Beehive-Engineering/Minibadge-Displays/4x7 Display/Combined PCBs bottom side.png

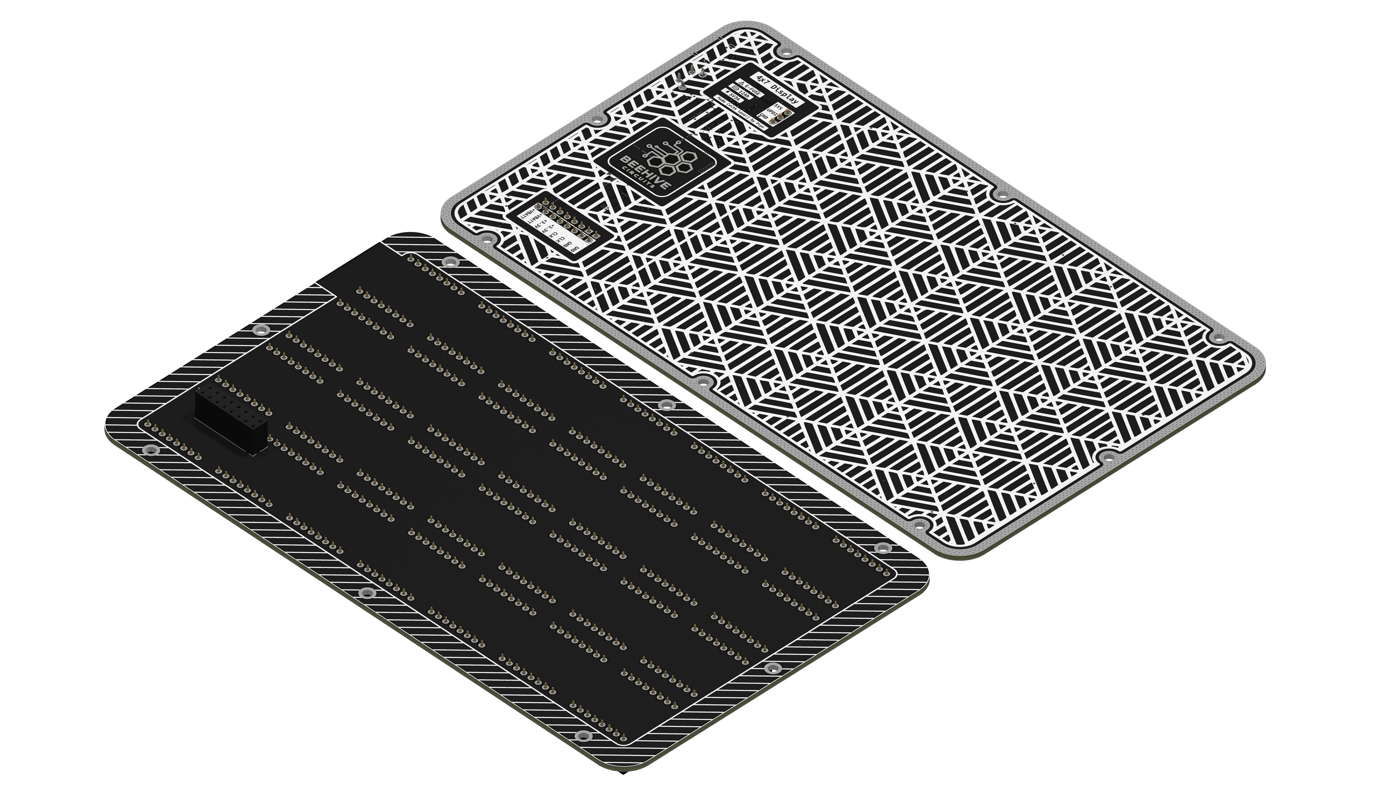
4x7 Display/Combined PCBs bottom side.png
