Beehive-Engineering/Minibadge-Displays/4x7 Display/Combined PCBs top side.png

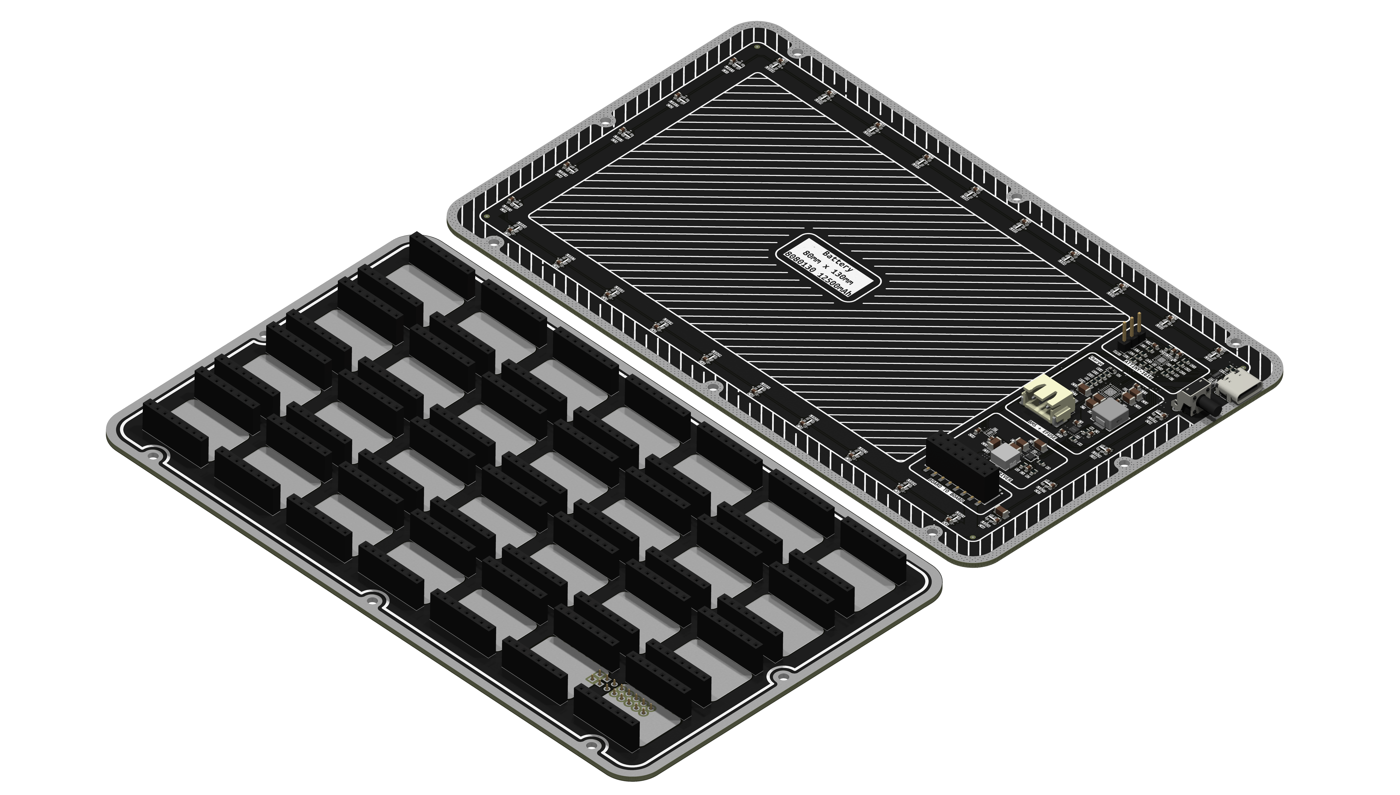
4x7 Display/Combined PCBs top side.png
