Beehive-Engineering/Minibadge-Displays/4x7 Display/Front PCB bottom.png

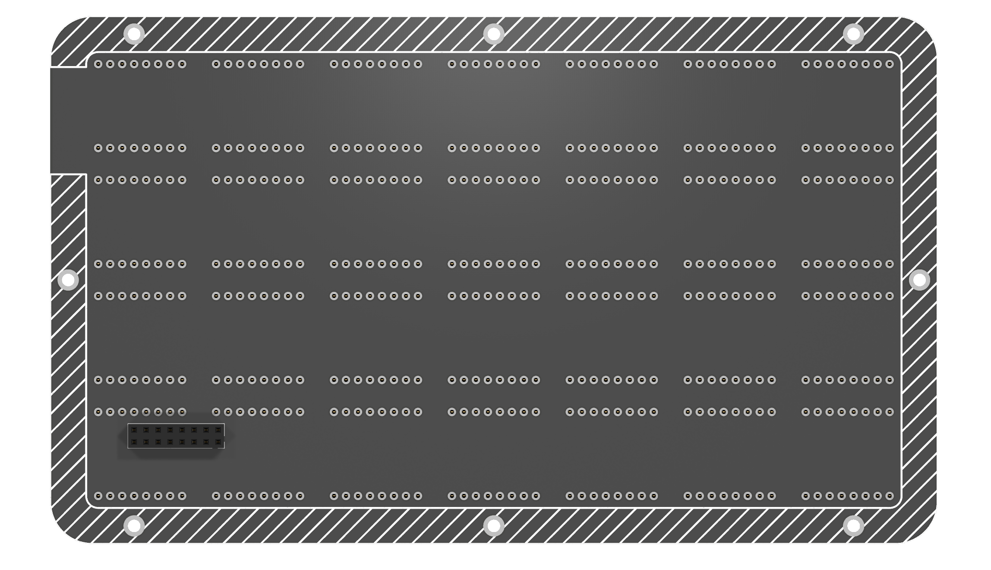
4x7 Display/Front PCB bottom.png
