Beehive-Engineering/Minibadge-Displays/4x7 Display/Front PCB top.png

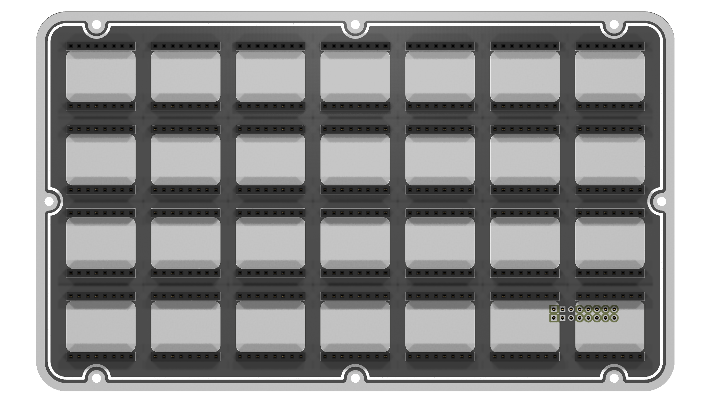
4x7 Display/Front PCB top.png
