Beehive-Engineering/Minibadge-Displays/4x7 Display/Main PCB bottom.png

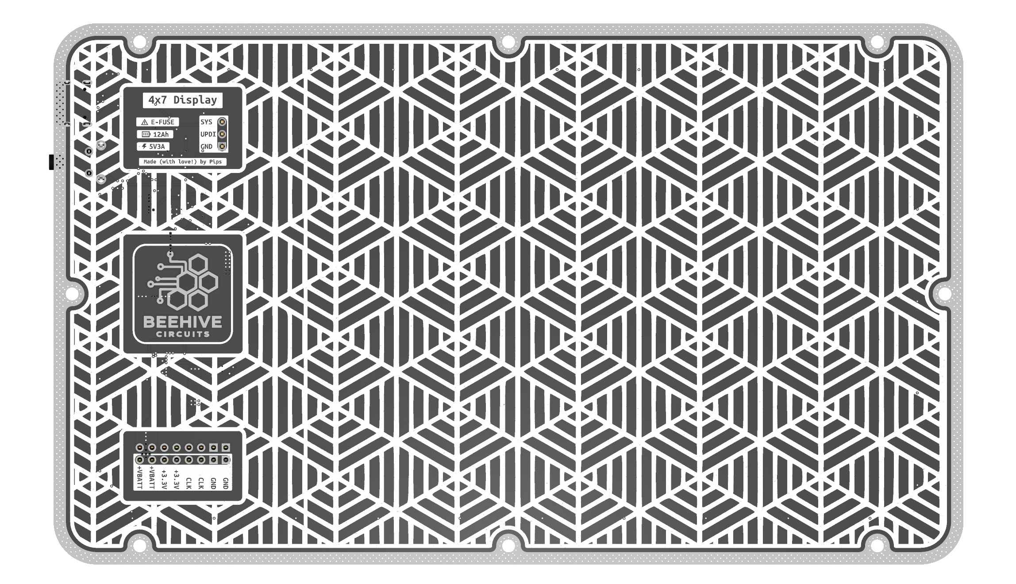
4x7 Display/Main PCB bottom.png
