Beehive-Engineering/Minibadge-Displays/4x7 Display/Main PCB top.png

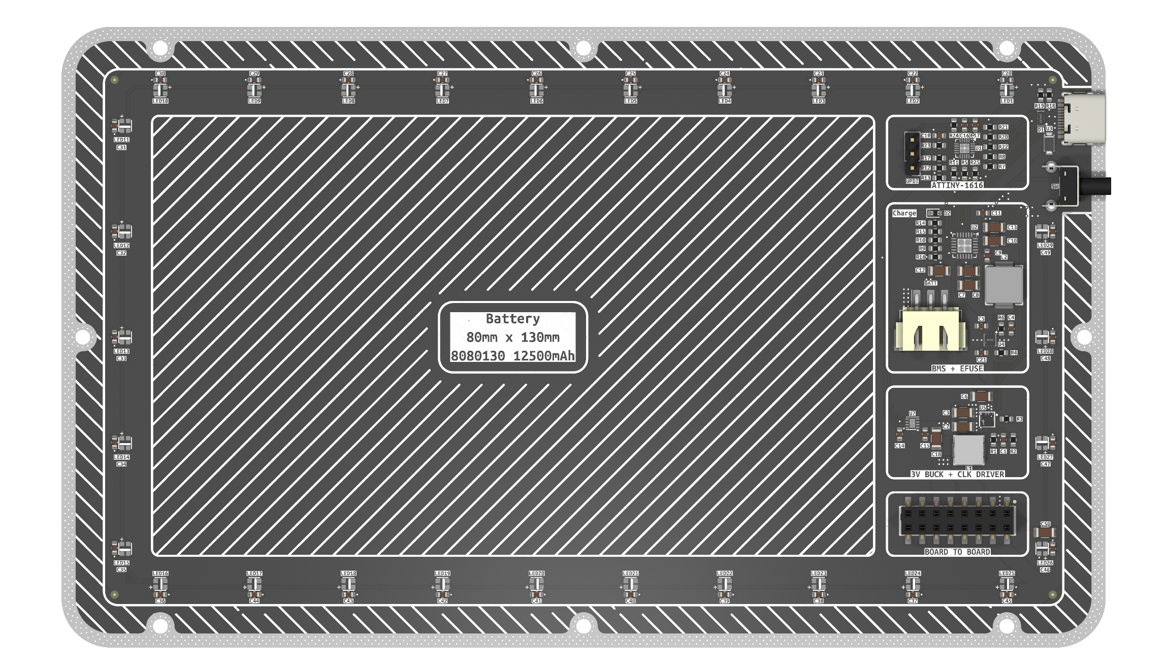
4x7 Display/Main PCB top.png
