Beehive-Engineering/Minibadge-Displays/4x7 Display/seamless-geometric-pattern-black-white-silhouette-abstract-repeating-thick-lines-115651497.webp

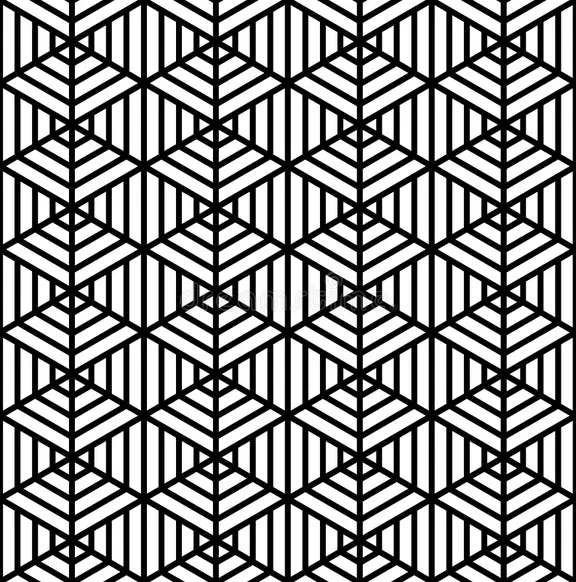
4x7 Display/seamless-geometric-pattern-black-white-silhouette-abstract-repeating-thick-lines-115651497.webp
