Beehive-Engineering/Minibadge-Displays/4x7 Display/4x7 Display-User_Comments.dxf

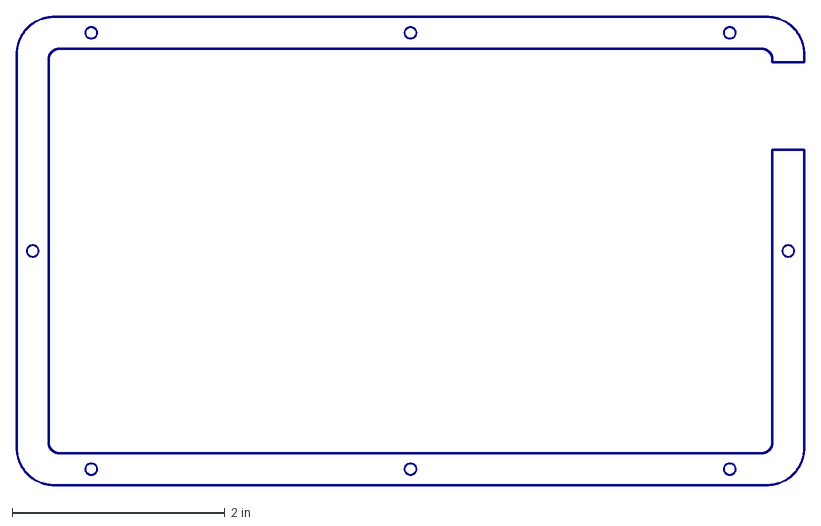
[picture p9: CAD file, 2026-11-13]
4x7 Display/4x7 Display-User_Comments.dxf
7.41 x 4.41 in
