Beehive-Engineering/Minibadge-Displays/4x7 Display/4x7 Display Schematic.pdf

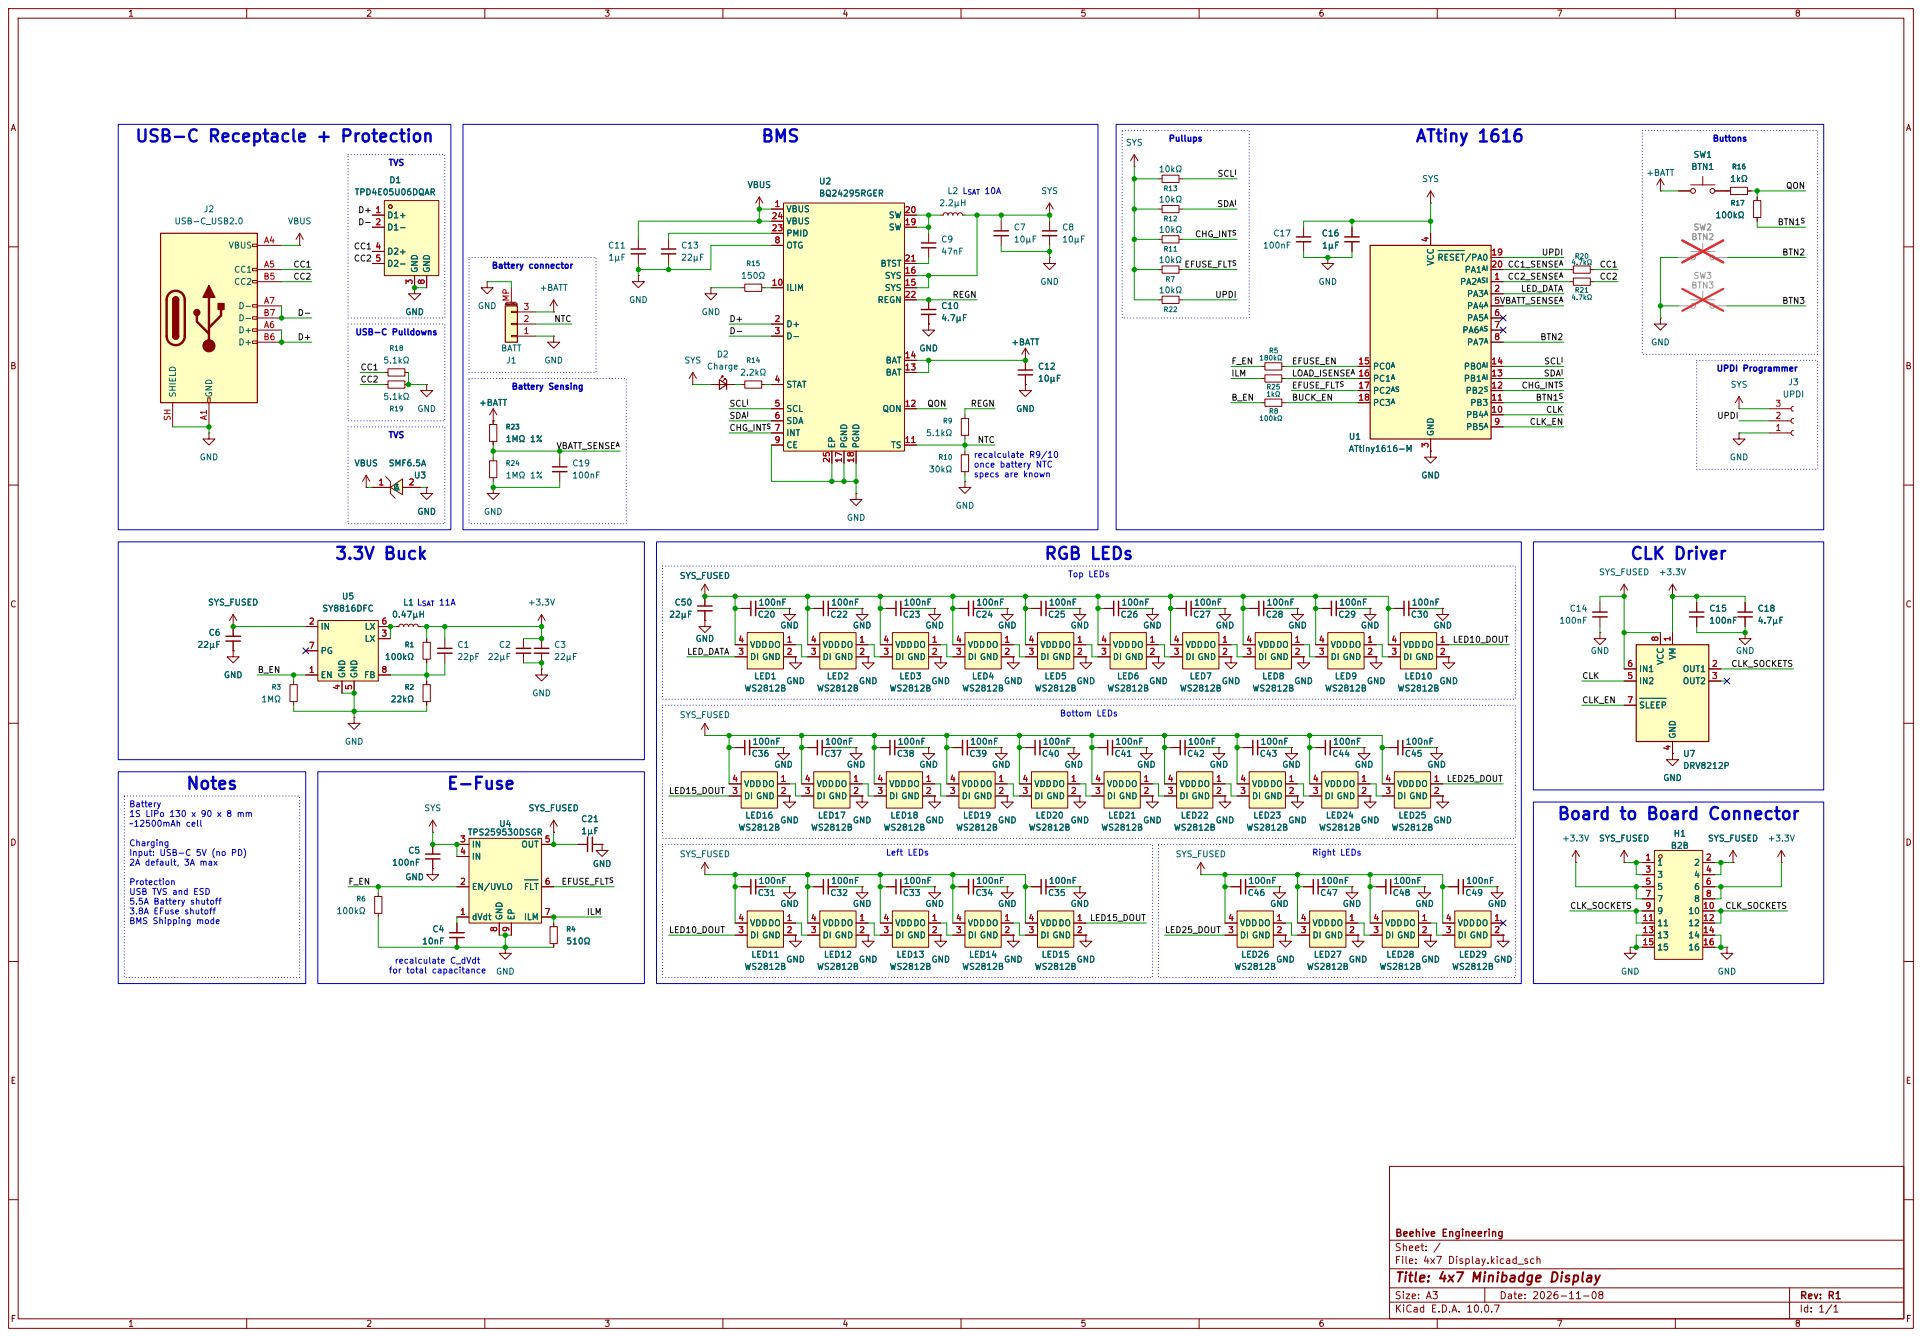
[picture p10: page 1]

VBUS C11
SYS 15 SYS 16 PGND 17 PGND 18

REGN
TS 11 QON 12 BAT 13 BAT 14
UPDI Programmer Left LEDs

Input: USB-C 5V (no PD) 2A default, 3A max Protection USB TVS and ESD

5.5A Battery shutoff 3.8A EFuse shutoff BMS Shipping mode

Size: A3 | Rev: R1 | F Date: 2026-11-08
KiCad E.D.A. 10.0.7 | Id: 1/1
