Beehive-Engineering/Minibadge-Displays/4x7 Display/4x7 Display Drawing.pdf

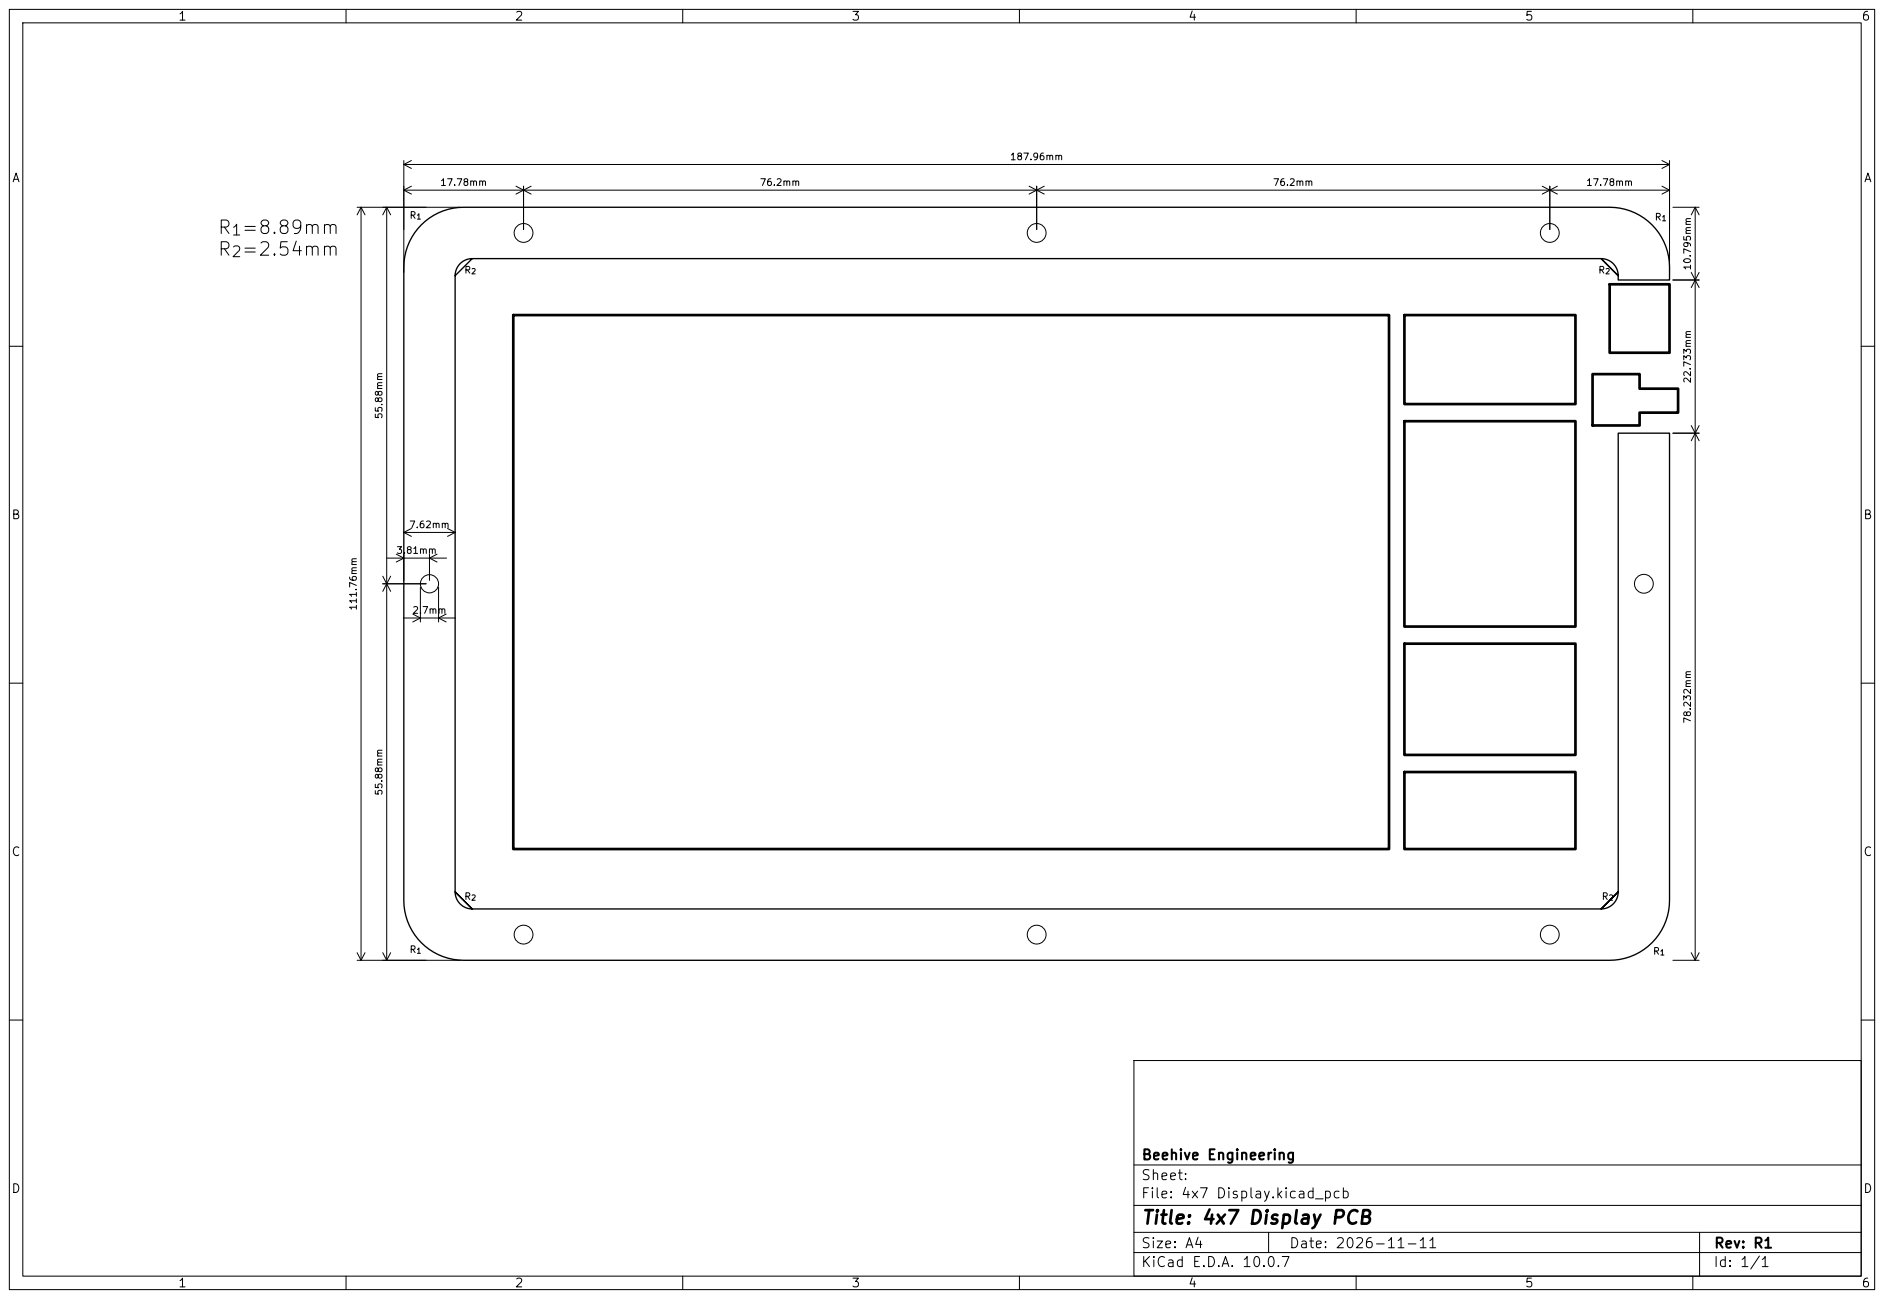
[picture p11: page 1]

Size: A4 | Rev: R1
KiCad E.D.A. 10.0.7 | Id: 1/1
