Beehive-Engineering/Minibadge-Displays/4x7 Display/4x7 Display PCB.pdf

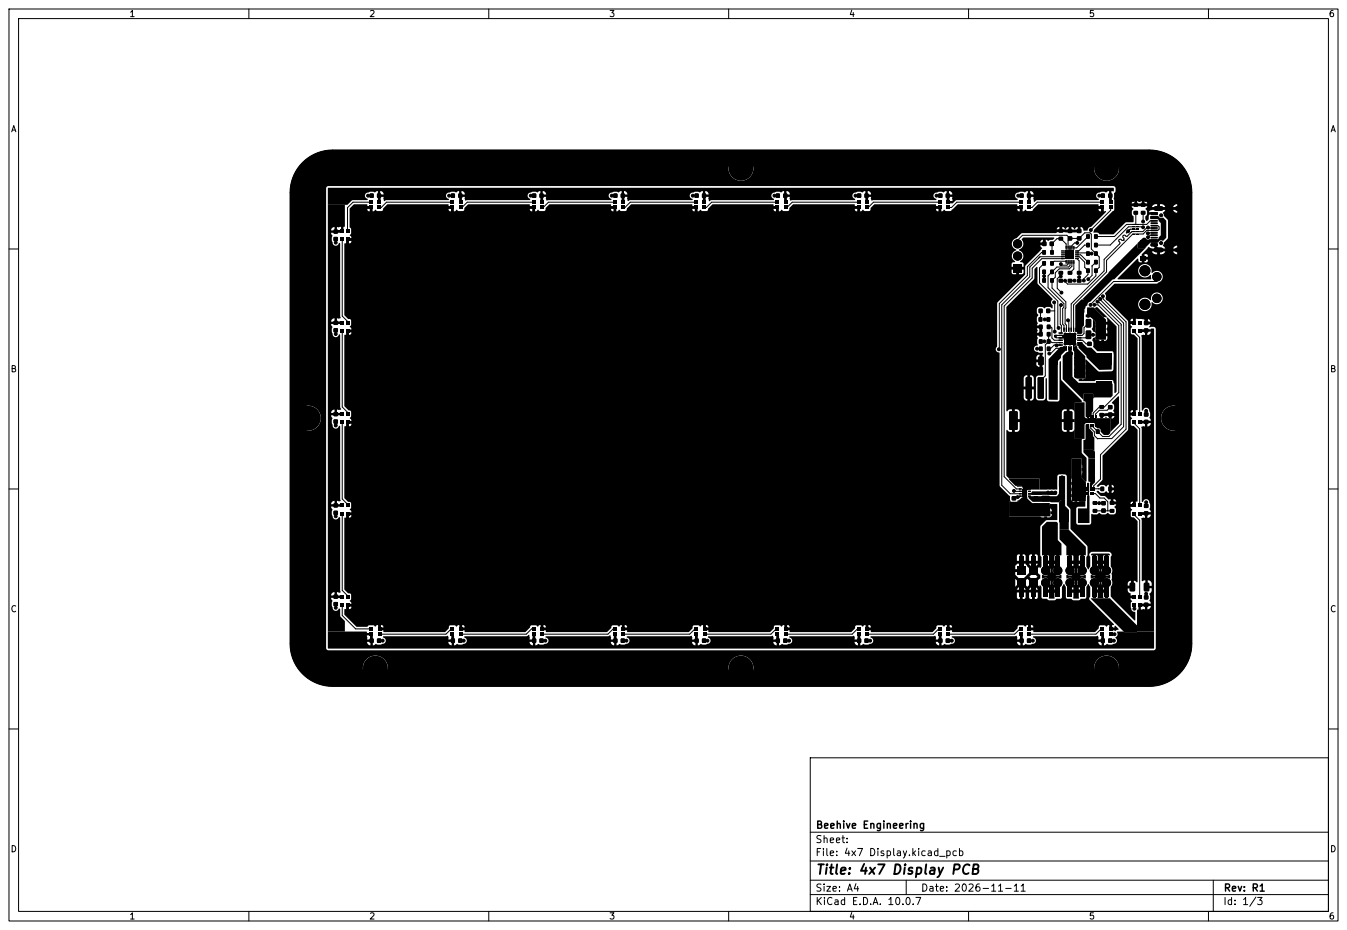
[picture p12: page 1]

Size: A4 | Rev: R1
KiCad E.D.A. 10.0.7 | Id: 1/3

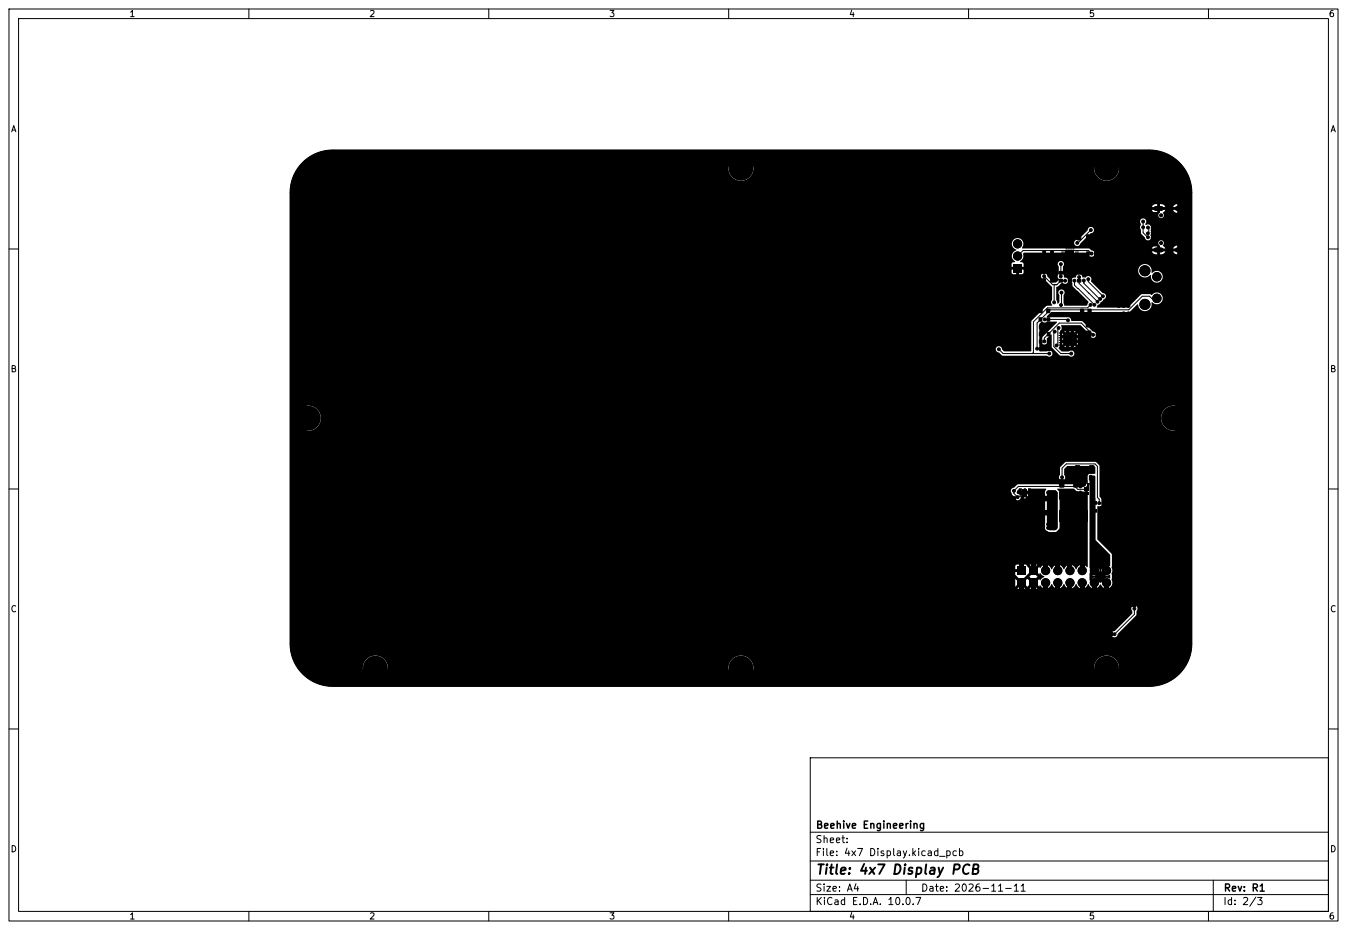
[picture p13: page 2]

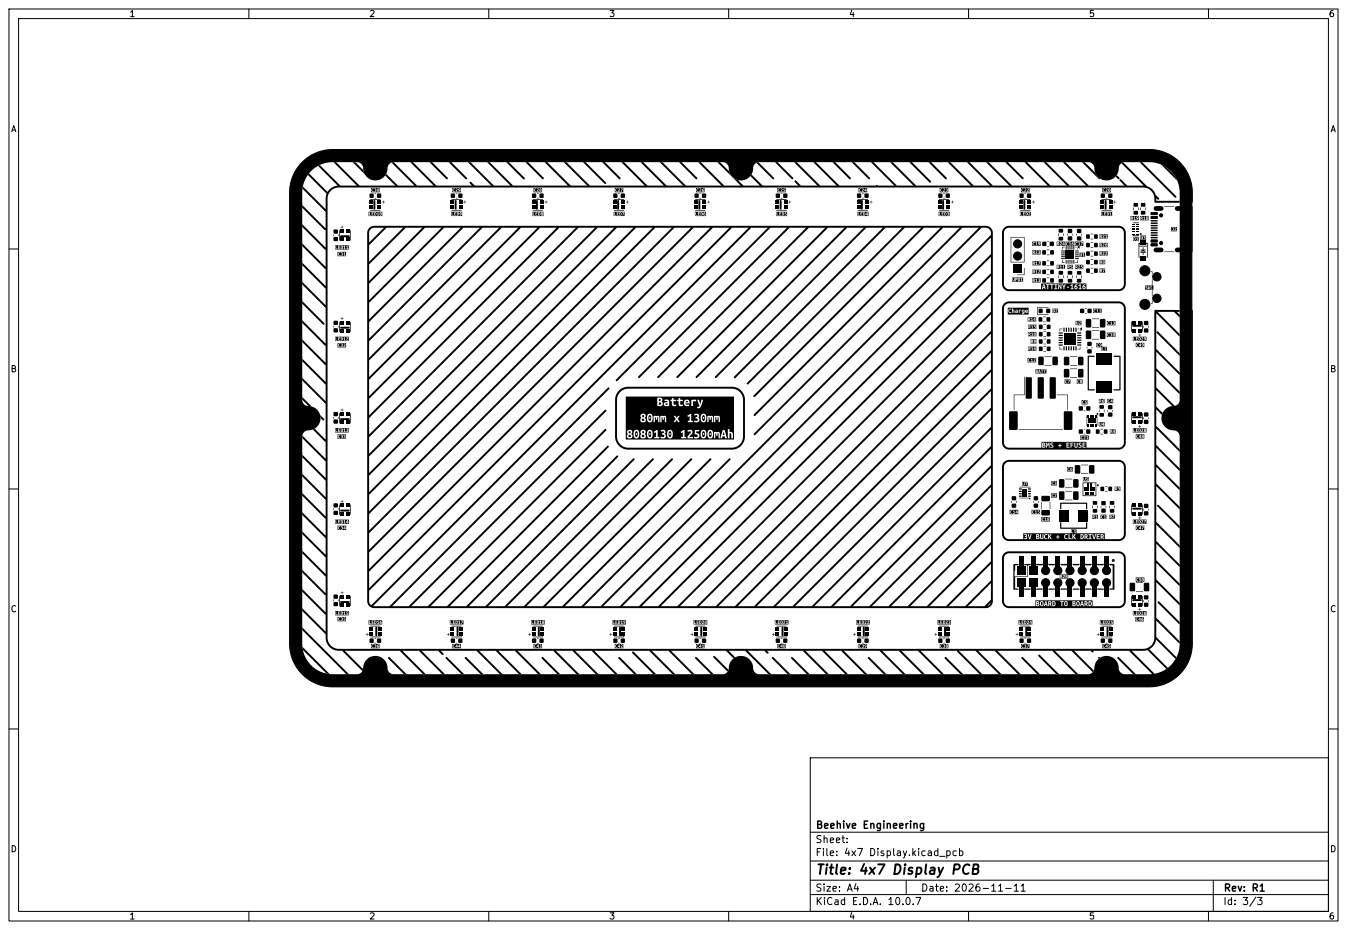
[picture p14: page 3]
