Beehive-Engineering/Minibadge-Displays/4x7 Display/4x7 Display Spacer.pdf

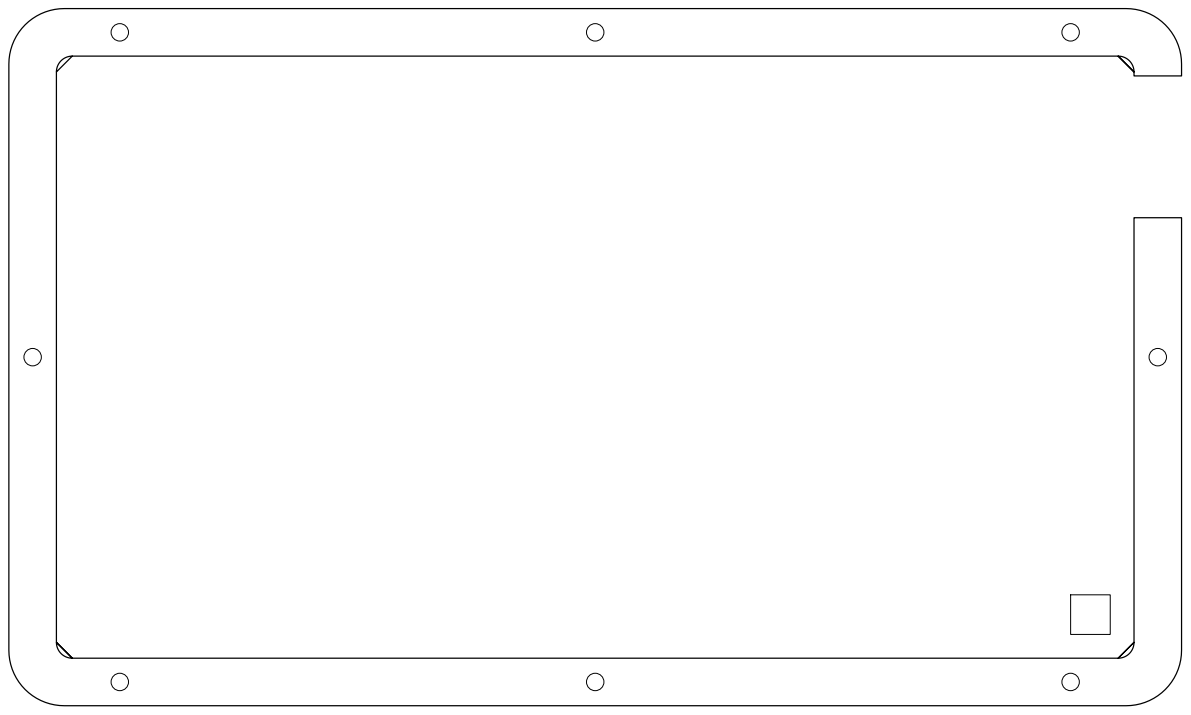
[picture p15: page 1]
