Beehive-Engineering/Minibadge-Displays/4x7 Display/4x7 Display-B_Silkscreen.pdf

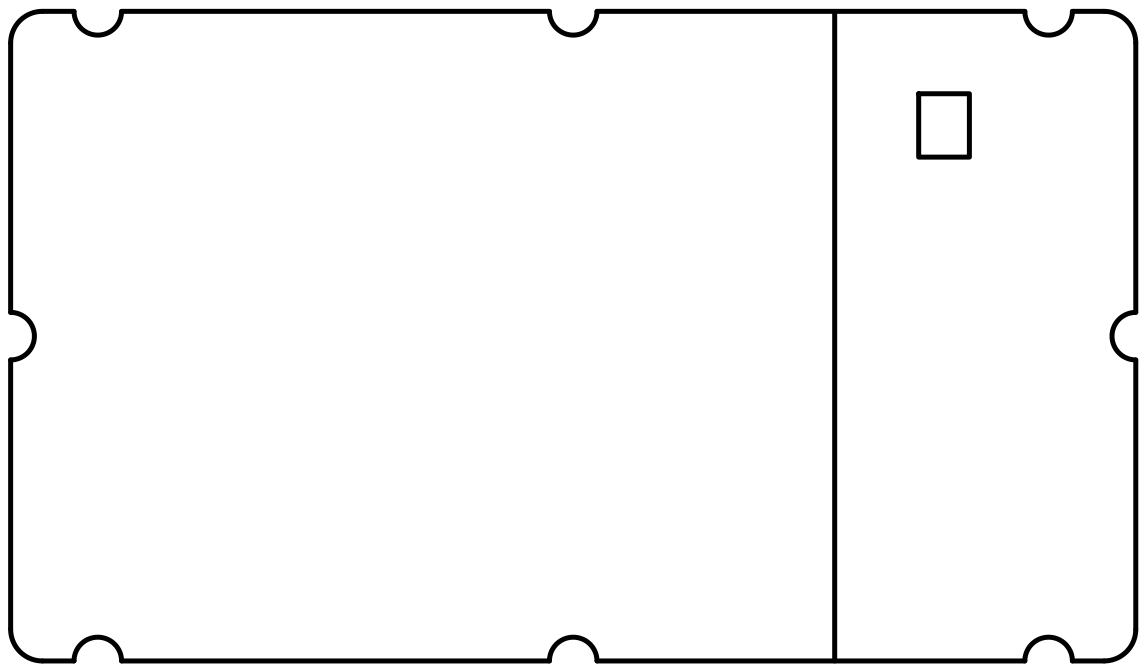
[picture p16: page 1]
