Beehive-Engineering/Minibadge-Displays/4x7 Display/4x7 Display.kicad_pcb

## KiCad design 4x7 Display/4x7 Display.kicad_pcb (2026-11-13)

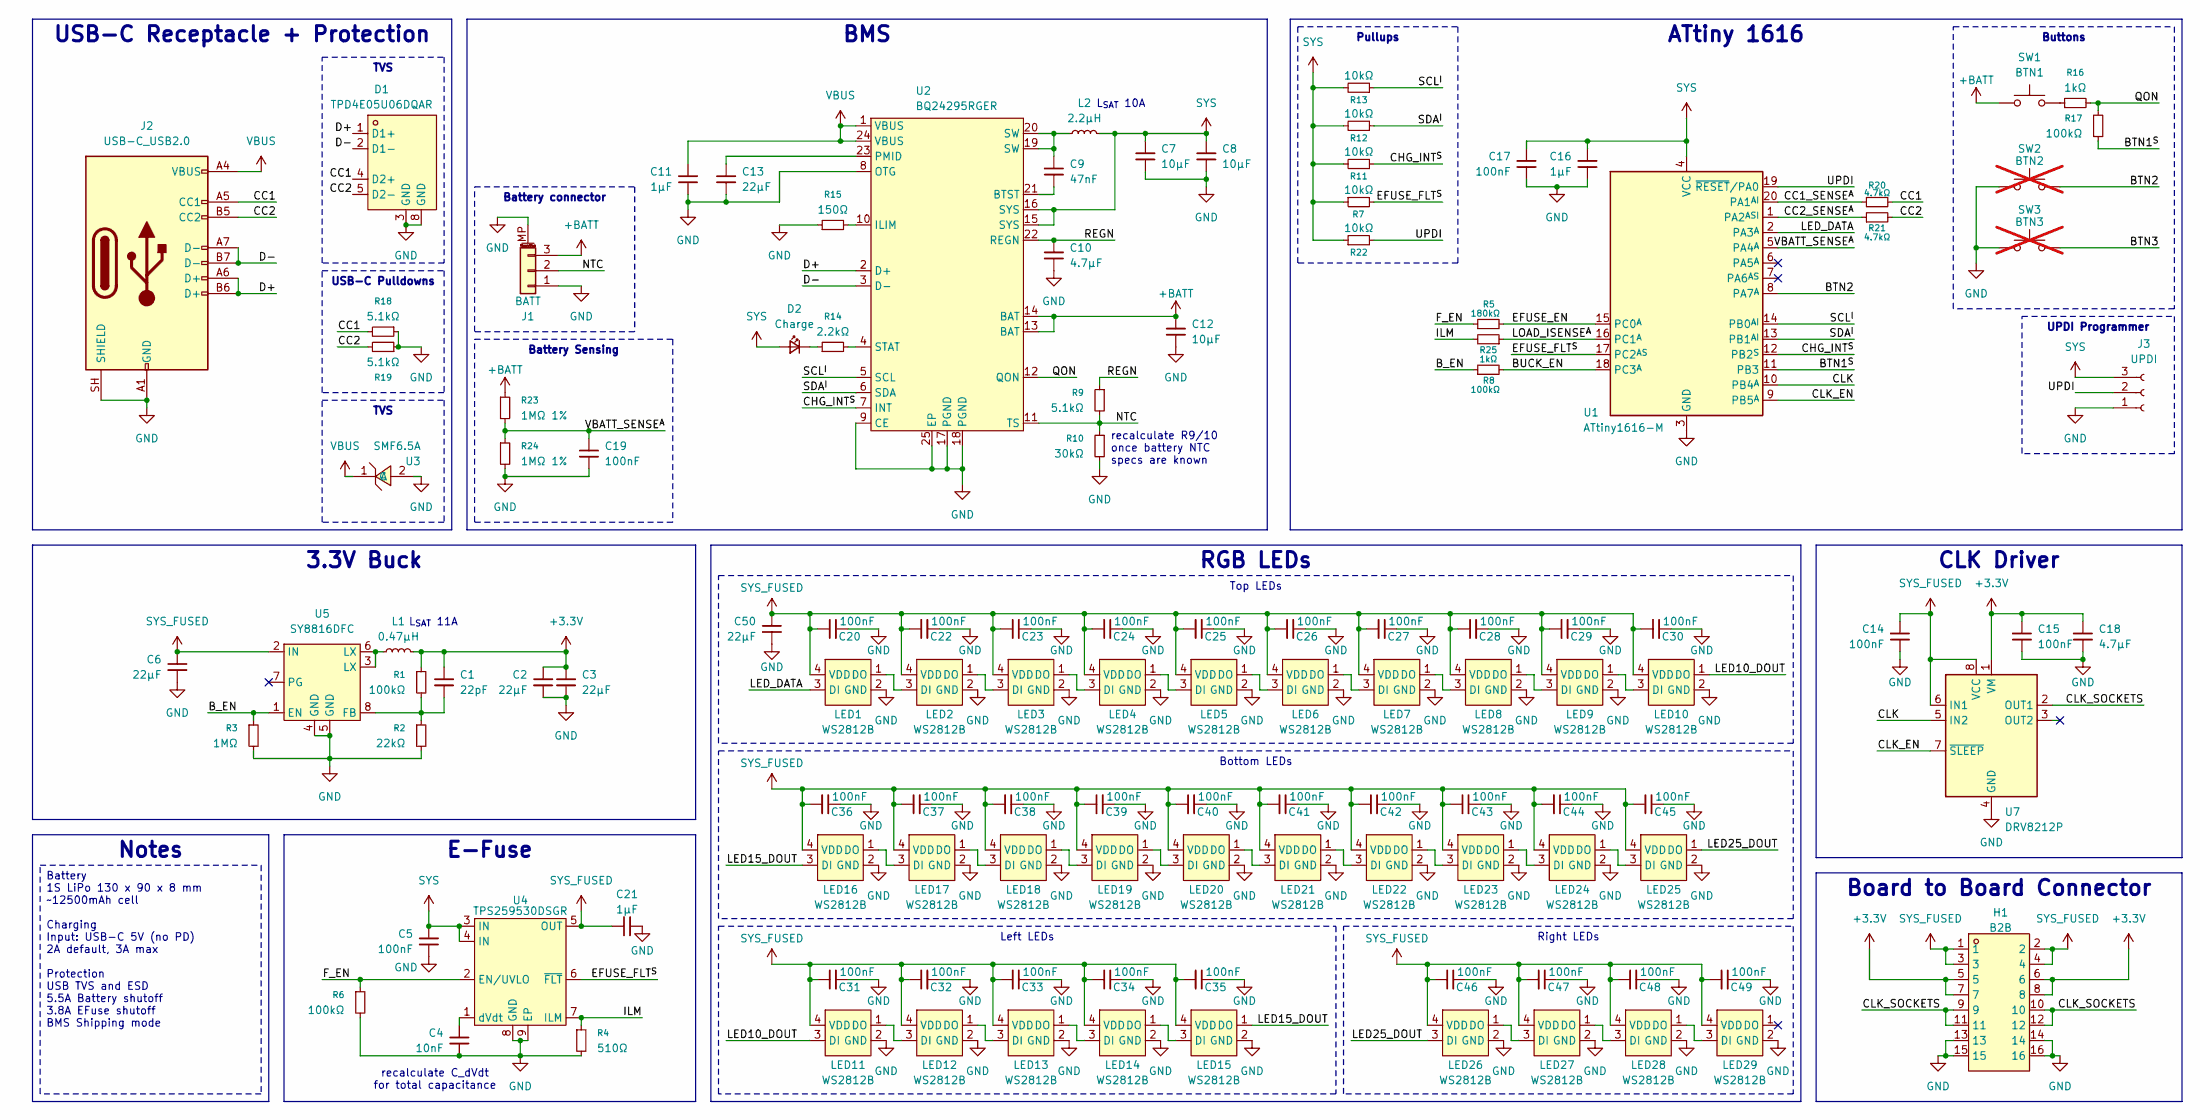
[picture p17: schematic 4x7 Display.kicad_sch, 4x7 Minibadge Display]

Parts:
C1: 22pF; C_0603_1608Metric; LCSC Part # C1653
C2, C3, C6, C13, C50: 22μF; C_1206_3216Metric; LCSC Part # C12891
C4: 10nF; C_0603_1608Metric; LCSC Part # C57112
C5, C14, C15, C17, C19, C20, C22, C23, C24, C25, C26, C27, C28, C29, C30, C31, C32, C33, C34, C35, C36, C37, C38, C39, C40, C41, C42, C43, C44, C45, C46, C47, C48, C49: 100nF; C_0603_1608Metric; LCSC Part # C14663
C7, C8, C12: 10μF; C_1206_3216Metric; LCSC Part # C13585
C9: 47nF; C_0603_1608Metric; LCSC Part # C1622
C10, C18: 4.7μF; C_1206_3216Metric; LCSC Part # C29823
C11, C16, C21: 1μF; C_0603_1608Metric; LCSC Part # C15849
D1: TPD4E05U06DQAR; USON-10_L2.5-W1.0-P0.50-BL; MPN TPD4E05U06DQAR; LCSC Part C138714
D2: Charge; D_0603_1608Metric; LCSC Part # C2286
H1: B2B; HDR-SMD_16P-P2.54-V-F-R2-C8-LS7.1; MPN PM254-2-08-S-8.5; LCSC Part C3975153
J1: BATT; JST_XH_S3B-XH-SM4-TB_1x03-1MP_P2.50mm_Horizontal
J2: USB-C_USB2.0; USB_C_Receptacle_HRO_TYPE-C-31-M-12; LCSC Part # C165948
J3: UPDI; PinHeader_1x03_P2.54mm_Vertical
L1: 0.47μH; IND-SMD_L5.4-W5.2_FXL0530
L2: 2.2μH; IND-SMD_L7.0-W6.6; LCSC Part # C167218
LED1, LED2, LED3, LED4, LED5, LED6, LED7, LED8, LED9, LED10, LED11, LED12, LED13, LED14, LED15, LED16, LED17, LED18, LED19, LED20, LED21, LED22, LED23, LED24, LED25, LED26, LED27, LED28, LED29: WS2812B; LED-SMD_4P-L2.2-W2.0-P1.00_WS2815C-2020-4P; MPN WS2812B-2020-V6; LCSC Part C52917434
R1, R6, R8, R17: 100kΩ; R_0603_1608Metric; LCSC Part # C25803
R2: 22kΩ; R_0603_1608Metric; LCSC Part # C31850
R3: 1MΩ; R_0603_1608Metric; LCSC Part # C22935
R4: 510Ω; R_0603_1608Metric; LCSC Part # C23193
R5: 180kΩ; R_0603_1608Metric; LCSC Part # C22827
R7, R11, R12, R13, R22: 10kΩ; R_0603_1608Metric; LCSC Part # C25804
R9, R18, R19: 5.1kΩ; R_0603_1608Metric; LCSC Part # C23186
R10: 30kΩ; R_0603_1608Metric; LCSC Part # C22984
R14: 2.2kΩ; R_0603_1608Metric; LCSC Part # C4190
R15: 150Ω; R_0603_1608Metric; LCSC Part # C22808
R16, R25: 1kΩ; R_0603_1608Metric; LCSC Part # C21190
R20, R21: 4.7kΩ; R_0603_1608Metric; LCSC Part # C23162
R23, R24: 1MΩ 1%; R_0603_1608Metric; LCSC Part # C22935
SW1: BTN1; SW_Tactile_SPST_Angled_PTS645Vx83-2LFS; LCSC Part # C127486
SW2: BTN2; SW_Tactile_SPST_Angled_PTS645Vx83-2LFS; LCSC Part # C125034; not fitted
SW3: BTN3; SW_Tactile_SPST_Angled_PTS645Vx83-2LFS; LCSC Part # C125034; not fitted
U1: ATtiny1616-M; VQFN-20-1EP_3x3mm_P0.4mm_EP1.7x1.7mm; LCSC Part # C507118
U2: BQ24295RGER; VQFN-24-1EP_4x4mm_P0.5mm_EP2.5x2.5mm_ThermalVias; MPN BQ24295RGER; LCSC Part C165144
U3: SMF6.5A; SOD-123FL_L2.8-W1.8-LS3.8-RD; MPN SMF6.5A; LCSC Part C5370410
U4: TPS259530DSGR; WSON-8_L2.0-W2.0-P0.50-TL-EP; MPN TPS259530DSGR; LCSC Part C2155775
U5: SY8816DFC; DFN-8_L2.0-W2.0_SY8816DFC; MPN SY8816DFC; LCSC Part C5440878
U7: DRV8212P; Texas_DSG0008A_WSON-8-1EP_2x2mm_P0.5mm_EP0.9x1.6mm_ThermalV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; LCSC Part # C5208051

Connections:
+3.3V: C1.1, C2.1, C3.1, C15.1, C18.1, H1.5, H1.6, H1.7, H1.8, L1.2, R1.1, U7.1 (VM)
+BATT: C12.1, J1.3, R23.1, SW1.1, U2.13 (BAT), U2.14 (BAT)
/BTN1^{S}: R17.1, U1.11 (PB3)
/BTN2: SW2.1, U1.8 (PA7^{A})
/BUCK_EN: R8.2, U1.18 (PC3^{A})
/B_EN: R3.1, R8.1, U5.1 (EN)
/CC1: D1.4 (D2+), J2.A5 (CC1), R18.2, R20.2
/CC1_SENSE^{A}: R20.1, U1.20 (PA1^{AI})
/CC2: D1.5 (D2-), J2.B5 (CC2), R19.2, R21.2
/CC2_SENSE^{A}: R21.1, U1.1 (PA2^{ASI})
/CHG_INT^{S}: R11.1, U1.12 (PB2^{S}), U2.7 (INT)
/CLK: U1.10 (PB4^{A}), U7.5 (IN2)
/CLK_EN: U1.9 (PB5^{A}), U7.7 (~SLEEP)
/CLK_SOCKETS: H1.9, H1.10, H1.11, H1.12, U7.2 (OUT1)
/D+: D1.1 (D1+), J2.A6 (D+), J2.B6 (D+), U2.2 (D+)
/D-: D1.2 (D1-), J2.A7 (D-), J2.B7 (D-), U2.3 (D-)
/EFUSE_EN: R5.2, U1.15 (PC0^{A})
/EFUSE_FLT^{S}: R7.2, U1.17 (PC2^{AS}), U4.6 (~FLT)
/F_EN: R5.1, R6.1, U4.2 (EN/UVLO)
/ILM: R4.1, R25.2, U4.7 (ILM)
/LED10_DOUT: LED10.1 (DO), LED11.3 (DI)
/LED15_DOUT: LED15.1 (DO), LED16.3 (DI)
/LED25_DOUT: LED25.1 (DO), LED26.3 (DI)
/LED_DATA: LED1.3 (DI), U1.2 (PA3^{A})
/LOAD_ISENSE^{A}: R25.1, U1.16 (PC1^{A})
/NTC: J1.2, R9.2, R10.1, U2.11 (TS)
/QON: R16.2, R17.2, U2.12 (QON)
/REGN: C10.1, R9.1, U2.22 (REGN)
/SCL^{I}: R13.1, U1.14 (PB0^{AI}), U2.5 (SCL)
/SDA^{I}: R12.1, U1.13 (PB1^{AI}), U2.6 (SDA)
/UPDI: J3.2, R22.2, U1.19 (~RESET/PA0)
/VBATT_SENSE^{A}: C19.1, R23.2, R24.1, U1.5 (PA4^{A})
GND: C2.2, C3.2, C4.2, C5.2, C6.2, C7.2, C8.2, C10.2, C11.2, C12.2, C13.1, C14.2, C15.2, C16.2, C17.2, C18.2, C19.2, C20.2, C21.2, C22.2, C23.2, C24.2, C25.2, C26.2, C27.2, C28.2, C29.2, C30.2, C31.2, C32.2, C33.2, C34.2, C35.2, C36.2, C37.2, C38.2, C39.2, C40.2, C41.2, C42.2, C43.2, C44.2, C45.2, C46.2, C47.2, C48.2, C49.2, C50.2, D1.3 (GND), D1.8 (GND), H1.13, H1.14, H1.15, H1.16, J1.1, J1.MP (MountPin), J2.A1 (GND), J2.A12 (GND), J2.B1 (GND), J2.B12 (GND), J2.SH (SHIELD), J3.1, LED1.2 (GND), LED2.2 (GND), LED3.2 (GND), LED4.2 (GND), LED5.2 (GND), LED6.2 (GND), LED7.2 (GND), LED8.2 (GND), LED9.2 (GND), LED10.2 (GND), LED11.2 (GND), LED12.2 (GND), LED13.2 (GND), LED14.2 (GND), LED15.2 (GND), LED16.2 (GND), LED17.2 (GND), LED18.2 (GND), LED19.2 (GND), LED20.2 (GND), LED21.2 (GND), LED22.2 (GND), LED23.2 (GND), LED24.2 (GND), LED25.2 (GND), LED26.2 (GND), LED27.2 (GND), LED28.2 (GND), LED29.2 (GND), R2.2, R3.2, R4.2, R6.2, R10.2, R15.1, R18.1, R19.1, R24.2, SW2.2, SW3.2, U1.3 (GND), U1.21 (GND), U2.8 (OTG), U2.9 (CE), U2.17 (PGND), U2.18 (PGND), U2.25 (EP), U3.2 (A), U4.8 (GND), U4.9 (EP), U5.4 (GND), U5.5 (GND), U7.4 (GND), U7.9 (GND)
unnamed: C9.1, L2.1, U2.19 (SW), U2.20 (SW)
unnamed: D2.1 (K), R14.1
unnamed: L1.1, U5.3 (LX), U5.6 (LX)
unnamed: LED1.1 (DO), LED2.3 (DI)
unnamed: LED2.1 (DO), LED3.3 (DI)
unnamed: LED3.1 (DO), LED4.3 (DI)
unnamed: LED4.1 (DO), LED5.3 (DI)
unnamed: LED5.1 (DO), LED6.3 (DI)
unnamed: LED6.1 (DO), LED7.3 (DI)
unnamed: LED7.1 (DO), LED8.3 (DI)
unnamed: LED8.1 (DO), LED9.3 (DI)
unnamed: LED9.1 (DO), LED10.3 (DI)
unnamed: LED11.1 (DO), LED12.3 (DI)
unnamed: LED12.1 (DO), LED13.3 (DI)
unnamed: LED13.1 (DO), LED14.3 (DI)
unnamed: LED14.1 (DO), LED15.3 (DI)
unnamed: LED16.1 (DO), LED17.3 (DI)
unnamed: LED17.1 (DO), LED18.3 (DI)
unnamed: LED18.1 (DO), LED19.3 (DI)
unnamed: LED19.1 (DO), LED20.3 (DI)
unnamed: LED20.1 (DO), LED21.3 (DI)
unnamed: LED21.1 (DO), LED22.3 (DI)
unnamed: LED22.1 (DO), LED23.3 (DI)
unnamed: LED23.1 (DO), LED24.3 (DI)
unnamed: LED24.1 (DO), LED25.3 (DI)
unnamed: LED26.1 (DO), LED27.3 (DI)
unnamed: LED27.1 (DO), LED28.3 (DI)
unnamed: LED28.1 (DO), LED29.3 (DI)
unnamed: R16.1, SW1.2
unnamed: C9.2, U2.21 (BTST)
unnamed: R15.2, U2.10 (ILIM)
unnamed: C13.2, U2.23 (PMID)
unnamed: R14.2, U2.4 (STAT)
unnamed: C4.1, U4.1 (dVdt)
unnamed: C1.2, R1.2, R2.1, U5.8 (FB)
SYS: C5.1, C7.1, C8.1, C16.1, C17.1, D2.2 (A), J3.3, L2.2, R7.1, R11.2, R12.2, R13.2, R22.1, U1.4 (VCC), U2.15 (SYS), U2.16 (SYS), U4.3 (IN), U4.4 (IN)
SYS_FUSED: C6.1, C14.1, C20.1, C21.1, C22.1, C23.1, C24.1, C25.1, C26.1, C27.1, C28.1, C29.1, C30.1, C31.1, C32.1, C33.1, C34.1, C35.1, C36.1, C37.1, C38.1, C39.1, C40.1, C41.1, C42.1, C43.1, C44.1, C45.1, C46.1, C47.1, C48.1, C49.1, C50.1, H1.1, H1.2, H1.3, H1.4, LED1.4 (VDD), LED2.4 (VDD), LED3.4 (VDD), LED4.4 (VDD), LED5.4 (VDD), LED6.4 (VDD), LED7.4 (VDD), LED8.4 (VDD), LED9.4 (VDD), LED10.4 (VDD), LED11.4 (VDD), LED12.4 (VDD), LED13.4 (VDD), LED14.4 (VDD), LED15.4 (VDD), LED16.4 (VDD), LED17.4 (VDD), LED18.4 (VDD), LED19.4 (VDD), LED20.4 (VDD), LED21.4 (VDD), LED22.4 (VDD), LED23.4 (VDD), LED24.4 (VDD), LED25.4 (VDD), LED26.4 (VDD), LED27.4 (VDD), LED28.4 (VDD), LED29.4 (VDD), U4.5 (OUT), U5.2 (IN), U7.6 (IN1), U7.8 (VCC)
VBUS: C11.1, J2.A4 (VBUS), J2.A9 (VBUS), J2.B4 (VBUS), J2.B9 (VBUS), U2.1 (VBUS), U2.24 (VBUS), U3.1 (C)

Notes on the sheet:
L_{SAT} 10A
recalculate R9/10 once battery NTC specs are known
L_{SAT} 11A
recalculate C_dVdt for total capacitance
CLK Driver
Battery Sensing
USB-C Receptacle + Protection
TVS
Battery connector
Right LEDs
Battery 1S LiPo 130 x 90 x 8 mm ~12500mAh cell Charging Input: USB-C 5V (no PD) 2A default, 3A max Protection USB TVS and ESD 5.5A Battery shutoff 3.8A EFuse shutoff BMS Shipping mode
3.3V Buck
USB-C Pulldowns
Notes
Left LEDs
Pullups
ATtiny 1616
BMS
Buttons
E-Fuse
RGB LEDs
Board to Board Connector
Bottom LEDs
UPDI Programmer
Top LEDs

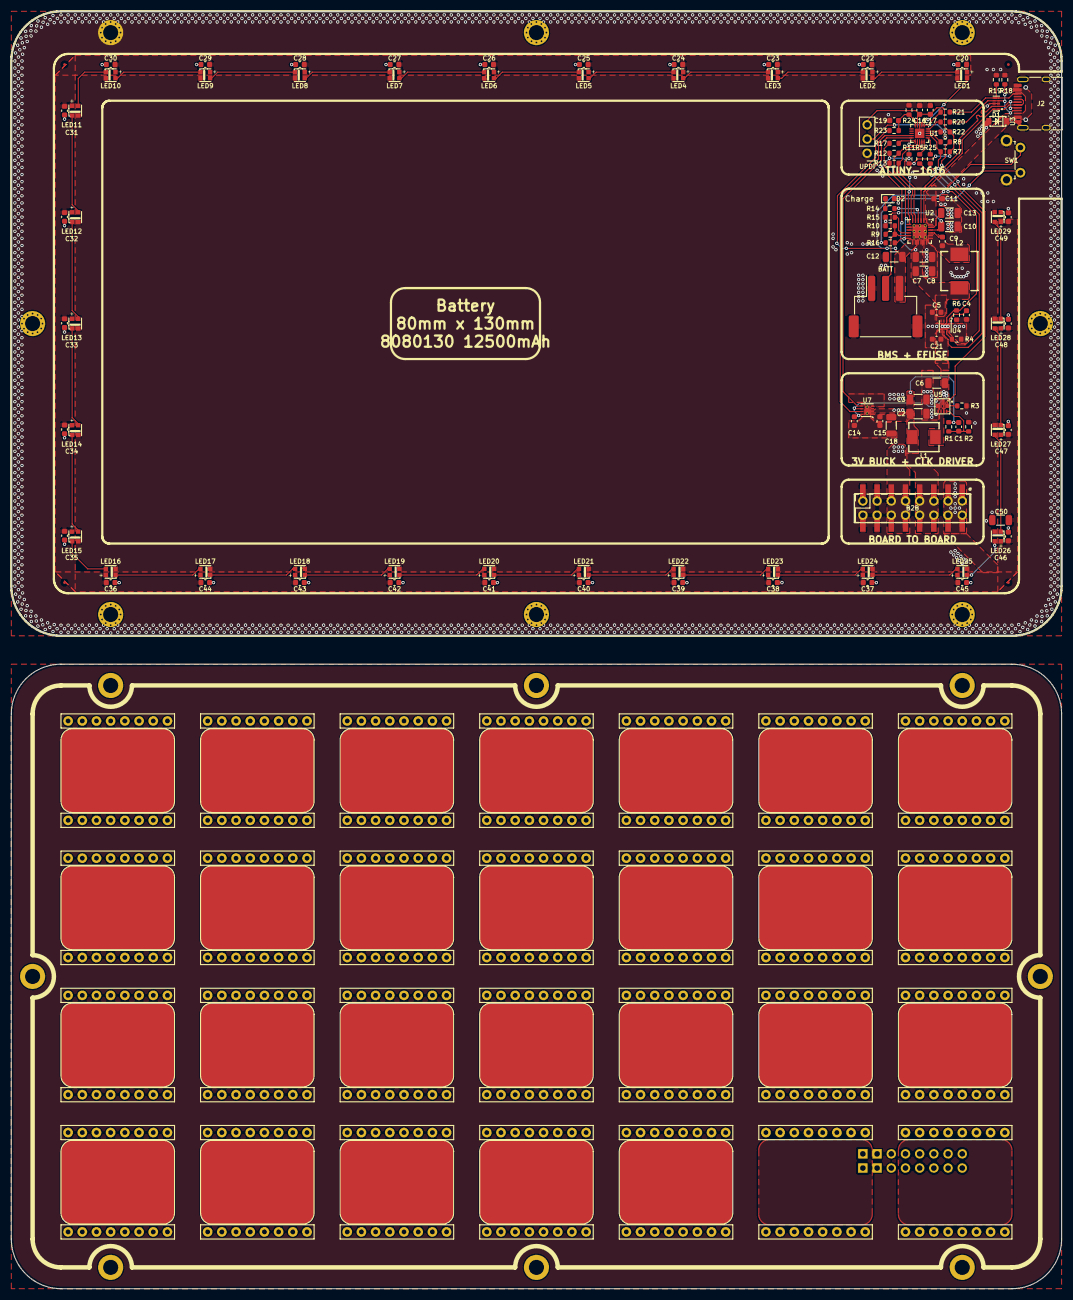
[picture p18: board 4x7 Display.kicad_pcb from above]

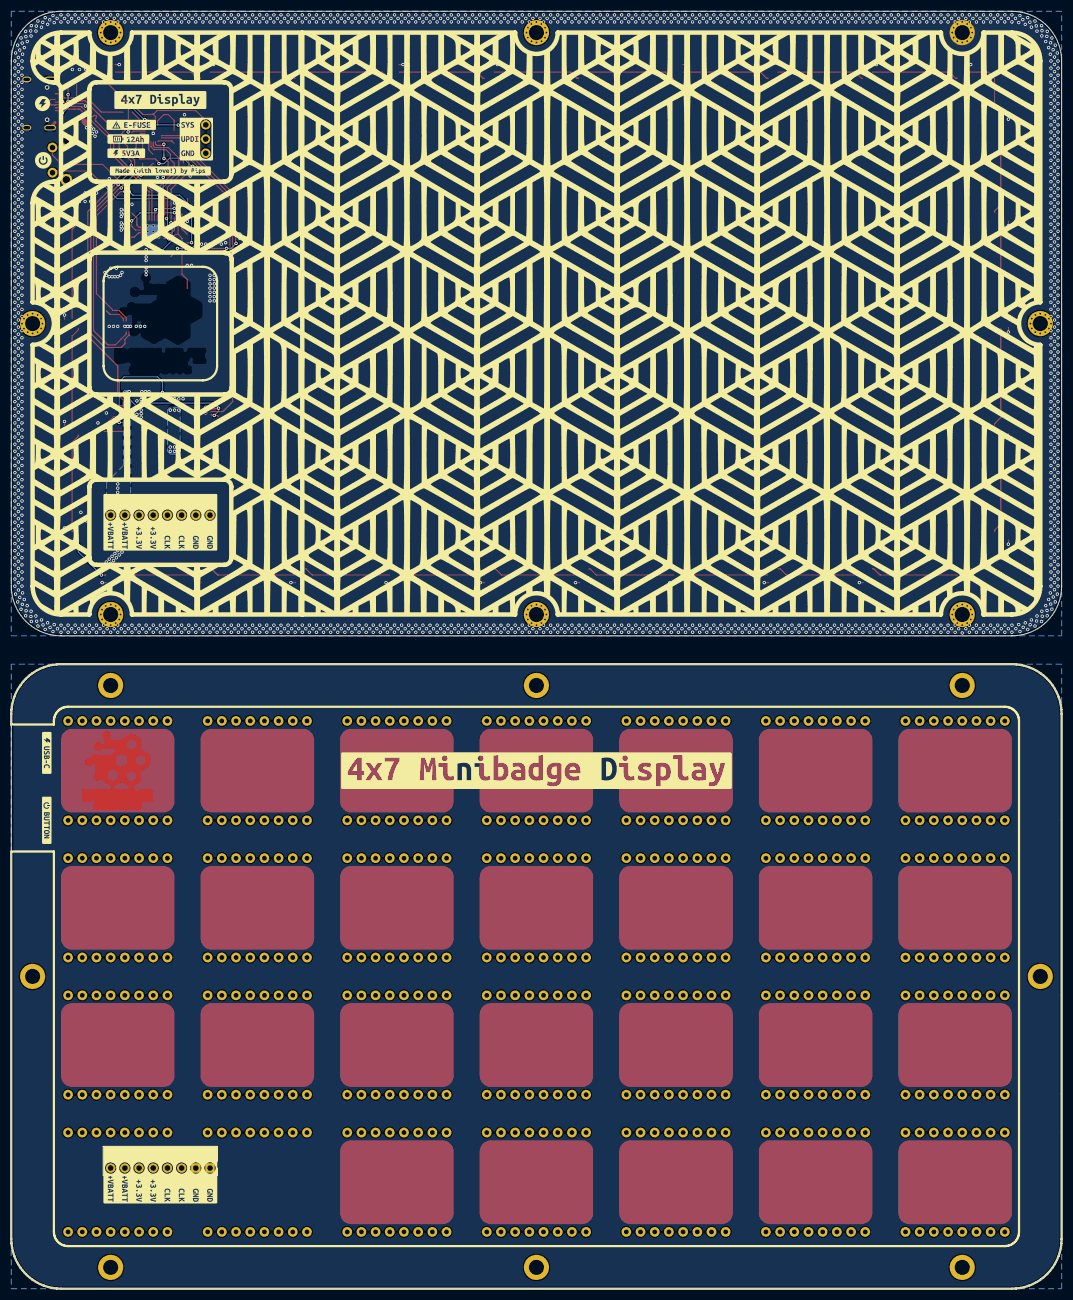
[picture p19: board 4x7 Display.kicad_pcb from below]

Board: 2 copper layers, 188.0 x 228.6 mm, 132 parts (13 on the bottom side), 70 nets.

Other parts of the board:
kobee-studio-6AF5A00E, kobee-studio-6AF59FA8, kobee-studio-6AF595D4, kobee-studio-6AF59616, kobee-studio-6AF59873: Kobee Studio; kobee-studio-6AF59280
kobee-studio-6AF6B32B, kobee-studio-6AF6B32B#2: Kobee Studio; kobee-studio-6AF51534
kobee-studio-6AF6C267: Kobee Studio; kobee-studio-6AF6C03E
kobee-studio-6AF59E14: Kobee Studio; kobee-studio-6AF517E5
kobee-studio-6AF62A46, kobee-studio-6AF62AB0: Kobee Studio; kobee-studio-6AF629F5
kobee-studio-6AF63128, kobee-studio-6AF63151: Kobee Studio; kobee-studio-6AF62E07
