Beehive-Engineering/Minibadge-Displays/Minibadge PD module/Minibadge PD module.kicad_pcb

## KiCad design Minibadge PD module/Minibadge PD module.kicad_pcb (2026-11-09)

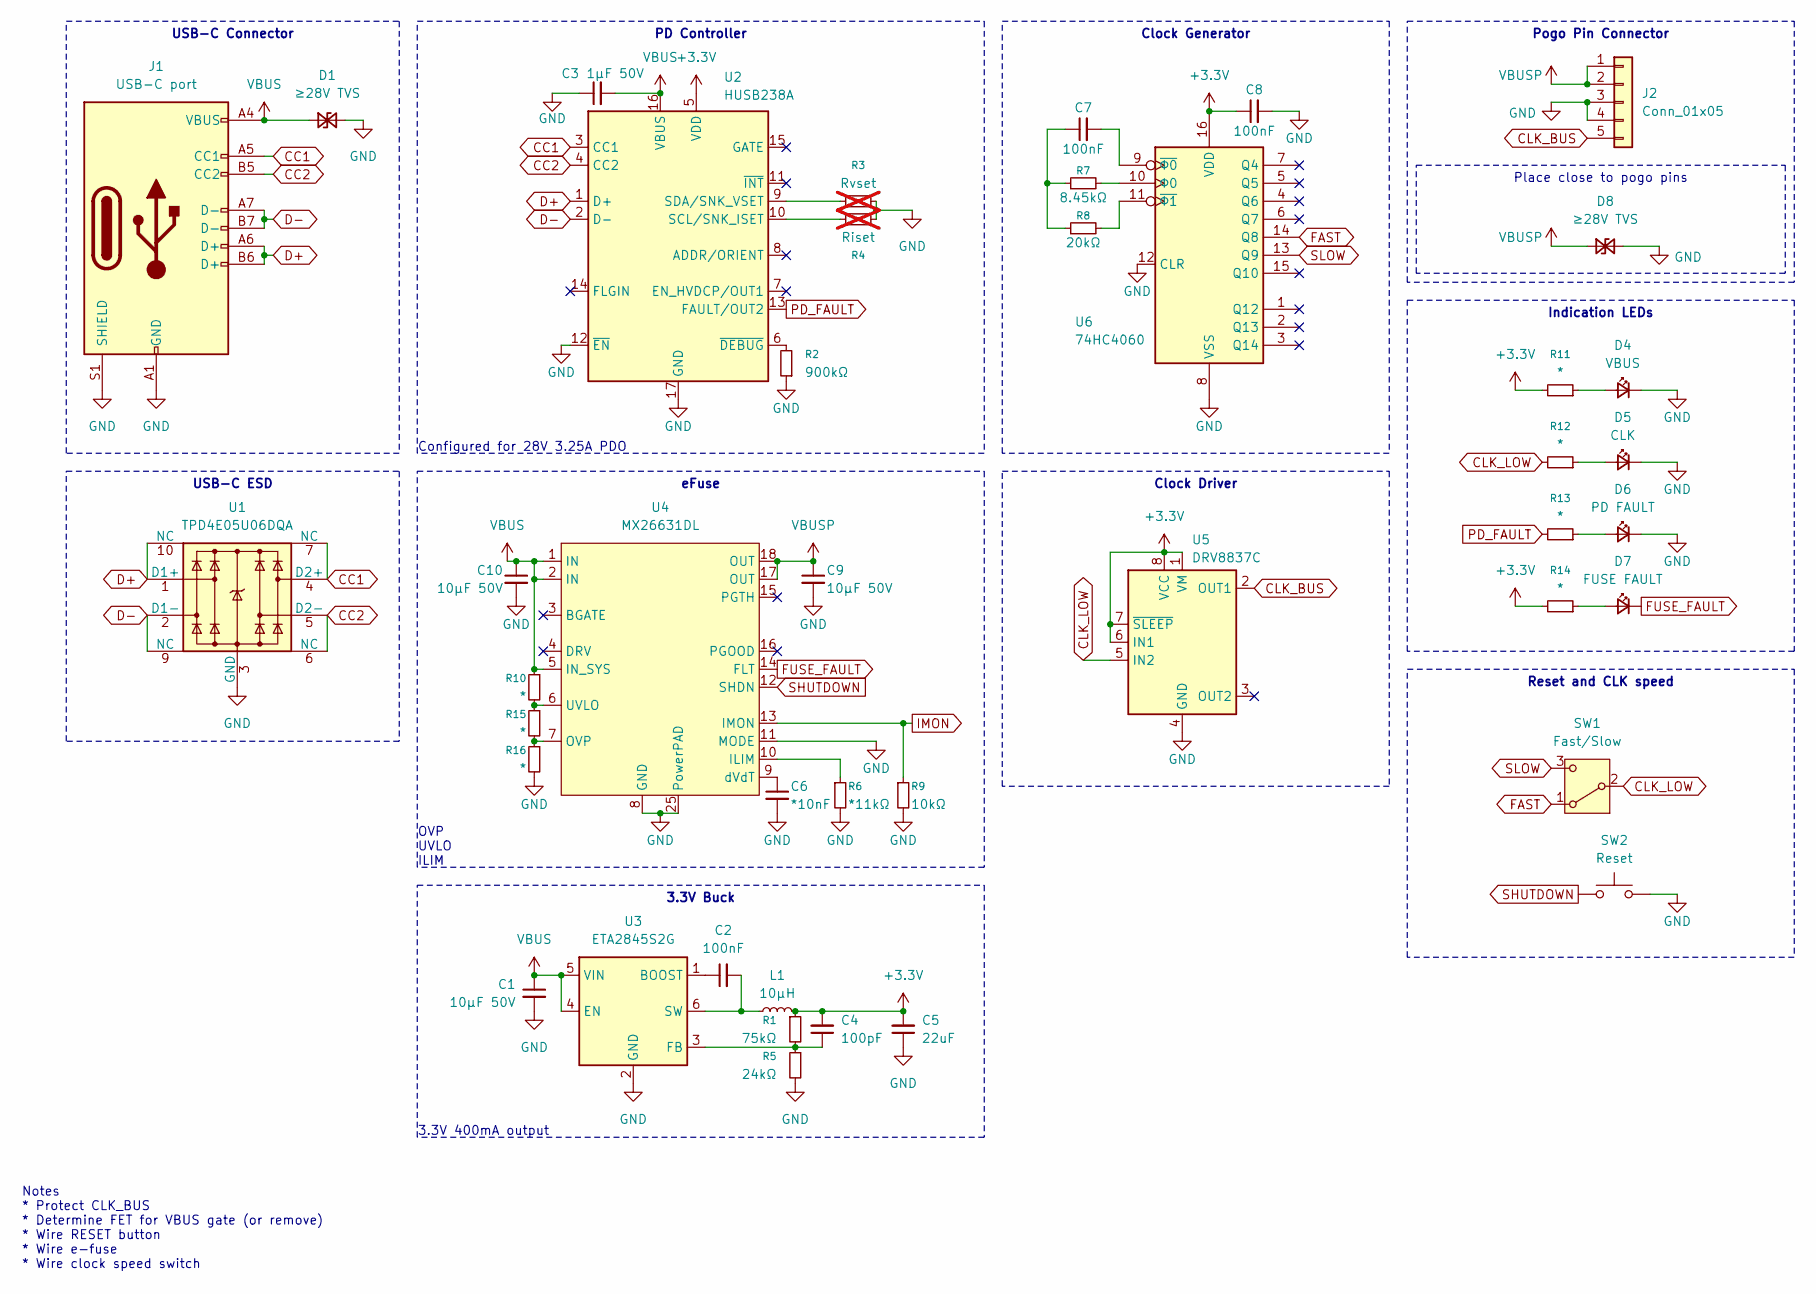
[picture p20: schematic Minibadge PD module.kicad_sch, Minibadge Display PD Module]

Parts:
C1, C9, C10: 10μF 50V; C_1206_3216Metric
C2, C7, C8: 100nF; C_0603_1608Metric
C3: 1μF 50V; C_0603_1608Metric
C4: 100pF; C_0603_1608Metric
C5: 22uF; C_1206_3216Metric
C6: *10nF; C_0603_1608Metric
D1, D8: ≥28V TVS; D_SMA
D4: VBUS; LED_0603_1608Metric
D5: CLK; LED_0603_1608Metric
D6: PD FAULT; LED_0603_1608Metric
D7: FUSE FAULT; LED_0603_1608Metric
J1: USB-C port; USB_C_Receptacle_HRO_TYPE-C-31-M-12
J2: Conn_01x05; PinHeader_1x05_P2.54mm_Horizontal
L1: 10μH; L_Taiyo-Yuden_MD-3030; LCSC Part # C668449
R1: 75kΩ; R_0603_1608Metric
R2: 900kΩ; R_0603_1608Metric
R3: Rvset; R_0603_1608Metric; not fitted
R4: Riset; R_0603_1608Metric; not fitted
R5: 24kΩ; R_0603_1608Metric
R6: *11kΩ; R_0603_1608Metric
R7: 8.45kΩ; R_0603_1608Metric
R8: 20kΩ; R_0603_1608Metric
R9: 10kΩ; R_0603_1608Metric
R10, R11, R12, R13, R14, R15, R16: *; R_0603_1608Metric
SW1: Fast/Slow
SW2: Reset
U1: TPD4E05U06DQA; USON-10_2.5x1.0mm_P0.5mm
U2: HUSB238A; WQFN-16-1EP_3x3mm_P0.5mm_EP1.75x1.75mm
U3: ETA2845S2G; TSOT-23-6; LCSC Part # C22362741
U4: MX26631DL; QFN-24-1EP_4x4mm_P0.5mm_EP2.6x2.6mm_ThermalVias
U5: DRV8837C; WSON-8-1EP_2x2mm_P0.5mm_EP0.9x1.6mm
U6: 74HC4060; TSSOP-16_4.4x5mm_P0.65mm

Connections:
+3.3V: C4.2, C5.2, C8.1, L1.2, R1.1, R11.2, R14.2, U2.5 (VDD), U5.1 (VM), U5.6 (IN1), U5.7 (~SLEEP), U5.8 (VCC), U6.16 (VDD)
CC1: J1.A5 (CC1), U1.4 (D2+), U1.7 (NC), U2.3 (CC1)
CC2: J1.B5 (CC2), U1.5 (D2-), U1.6 (NC), U2.4 (CC2)
CLK_BUS: J2.5, U5.2 (OUT1)
CLK_LOW: R12.2, SW1.2 (B), U5.5 (IN2)
D+: J1.A6 (D+), J1.B6 (D+), U1.1 (D1+), U1.10 (NC), U2.1 (D+)
D-: J1.A7 (D-), J1.B7 (D-), U1.2 (D1-), U1.9 (NC), U2.2 (D-)
FAST: SW1.1 (A), U6.14 (Q8)
FUSE_FAULT: D7.1 (K), U4.14 (FLT)
GND: C1.2, C3.1, C5.1, C6.2, C8.2, C9.2, C10.2, D1.2 (A2), D4.1 (K), D5.1 (K), D6.1 (K), D8.2 (A2), J1.A1 (GND), J1.A12 (GND), J1.B1 (GND), J1.B12 (GND), J1.S1 (SHIELD), J2.3, J2.4, R2.1, R3.2, R4.1, R5.2, R6.2, R9.2, R16.2, SW2.2, U1.3 (GND), U1.8 (GND), U2.12 (~EN), U2.17 (GND), U3.2 (GND), U4.8 (GND), U4.11 (MODE), U4.25 (PowerPAD), U5.4 (GND), U5.9 (GND), U6.8 (VSS), U6.12 (CLR)
IMON: R9.1, U4.13 (IMON)
unnamed: C7.1, R7.1, R8.1
unnamed: D4.2 (A), R11.1
unnamed: D5.2 (A), R12.1
unnamed: D6.2 (A), R13.1
unnamed: D7.2 (A), R14.1
unnamed: R4.2, U2.10 (SCL/SNK_ISET)
unnamed: R3.1, U2.9 (SDA/SNK_VSET)
unnamed: R2.2, U2.6 (~DEBUG)
unnamed: C2.1, U3.1 (BOOST)
unnamed: C4.1, R1.2, R5.1, U3.3 (FB)
unnamed: C2.2, L1.1, U3.6 (SW)
unnamed: R6.1, U4.10 (ILIM)
unnamed: R15.2, R16.1, U4.7 (OVP)
unnamed: R10.2, R15.1, U4.6 (UVLO)
unnamed: C6.1, U4.9 (dVdT)
unnamed: C7.2, U6.9 (~Φ0)
unnamed: R8.2, U6.11 (~Φ1)
unnamed: R7.2, U6.10 (Φ0)
PD_FAULT: R13.2, U2.13 (FAULT/OUT2)
SHUTDOWN: SW2.1, U4.12 (SHDN)
SLOW: SW1.3 (C), U6.13 (Q9)
VBUS: C1.1, C3.2, C10.1, D1.1 (A1), J1.A4 (VBUS), J1.A9 (VBUS), J1.B4 (VBUS), J1.B9 (VBUS), R10.1, U2.16 (VBUS), U3.4 (EN), U3.5 (VIN), U4.1 (IN), U4.2 (IN), U4.5 (IN_SYS)
VBUSP: C9.1, D8.1 (A1), J2.1, J2.2, U4.17 (OUT), U4.18 (OUT)

Notes on the sheet:
OVP UVLO ILIM
3.3V 400mA output
Notes * Protect CLK_BUS * Determine FET for VBUS gate (or remove) * Wire RESET button * Wire e-fuse * Wire clock speed switch
Configured for 28V 3.25A PDO
Reset and CLK speed
3.3V Buck
USB-C Connector
USB-C ESD
Clock Generator
Clock Driver
eFuse
Pogo Pin Connector
Indication LEDs
PD Controller
Place close to pogo pins

Board: 2 copper layers, 41 parts (0 on the bottom side), 31 nets, no tracks yet.
