Beehive-Engineering/Minibadge-Displays/5x5 Display/5x5 Display.kicad_pcb

## KiCad design 5x5 Display/5x5 Display.kicad_pcb (2026-11-09)

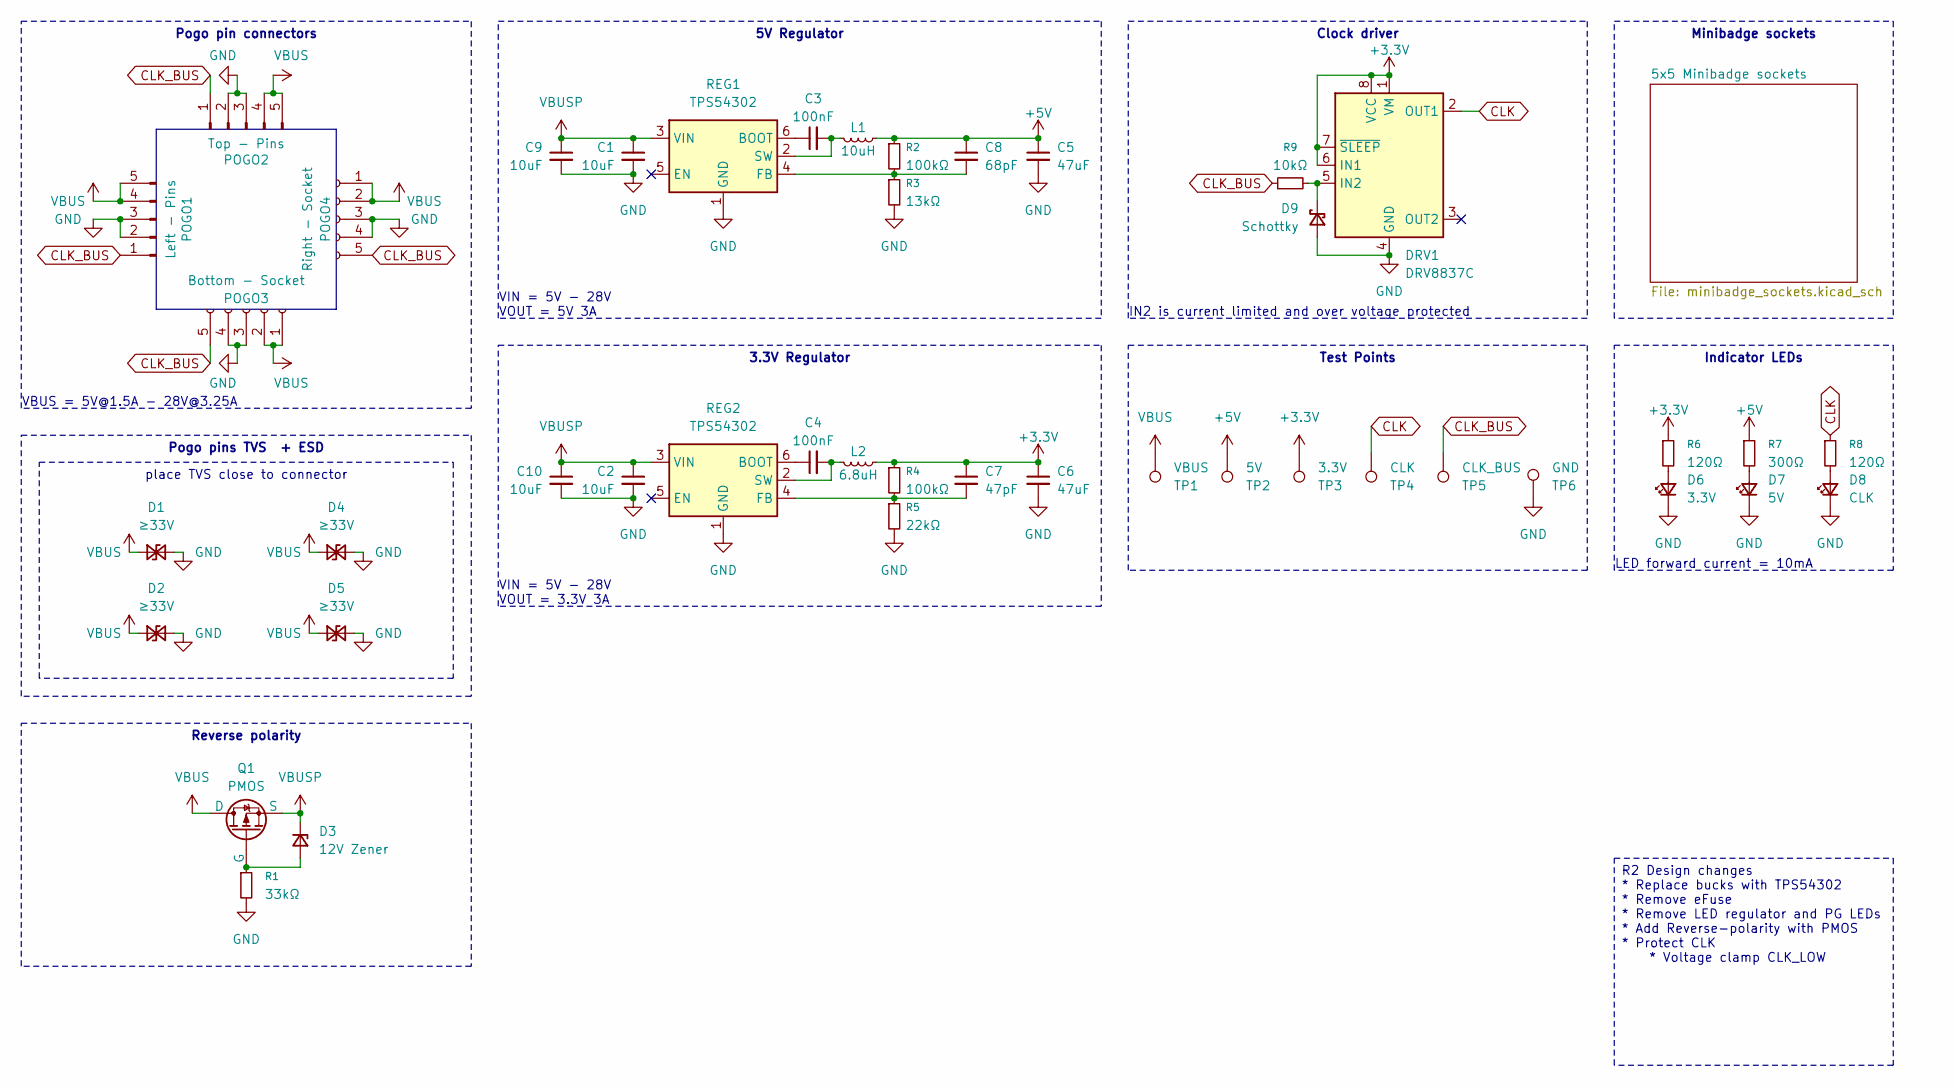
[picture p21: schematic 5x5 Display.kicad_sch, 5x5 Tileable Minibadge Display]

Parts:
C1, C2, C9, C10: 10uF; C_1206_3216Metric; LCSC Part # C13585
C3, C4: 100nF; C_0805_2012Metric; LCSC Part # C28233
C5, C6: 47uF; C_1206_3216Metric; LCSC Part # C96123
C7: 47pF; C_0603_1608Metric; LCSC Part # C1671
C8: 68pF; C_0603_1608Metric; LCSC Part # C28262
D1, D2, D4, D5: ≥33V; D_SMA; LCSC Part # C134981
D3: 12V Zener; D_SOD-123; LCSC Part # C22435092
D6: 3.3V; LED_0805_2012Metric; LCSC Part # C84256
D7: 5V; LED_0805_2012Metric; LCSC Part # C84256
D8: CLK; LED_0805_2012Metric; LCSC Part # C84256
D9: Schottky; D_SOD-123; LCSC Part # C7420325
DRV1: DRV8837C; WSON-8-1EP_2x2mm_P0.5mm_EP0.9x1.6mm; LCSC Part # C191000
L1: 10uH; L_TechFuse_SL0630; LCSC Part # C5189958
L2: 6.8uH; L_TechFuse_SL0630; LCSC Part # C5189749
POGO1: Left - Pins; PinSocket_1x05_P2.54mm_Horizontal
POGO2: Top - Pins; PinSocket_1x05_P2.54mm_Horizontal
POGO3: Bottom - Socket; PinSocket_1x05_P2.54mm_Horizontal
POGO4: Right - Socket; PinSocket_1x05_P2.54mm_Horizontal
Q1: PMOS; PQFN-8-EP_6x5mm_P1.27mm_Generic; LCSC Part # C51625746
R1: 33kΩ; R_0805_2012Metric
R2, R4: 100kΩ; R_0805_2012Metric; LCSC Part # C149504
R3: 13kΩ; R_0805_2012Metric; LCSC Part # C17455
R5: 22kΩ; R_0805_2012Metric; LCSC Part # C17560
R6, R8: 120Ω; R_0805_2012Metric; LCSC Part # C17437
R7: 300Ω; R_0805_2012Metric; LCSC Part # C17617
R9: 10kΩ; R_0805_2012Metric; LCSC Part # C17414
REG1, REG2: TPS54302; SOT-23-6; LCSC Part # C311983
TP1: VBUS; TestPoint_Pad_D1.5mm
TP2: 5V; TestPoint_Pad_D1.5mm
TP3: 3.3V; TestPoint_Pad_D1.5mm
TP4: CLK; TestPoint_Pad_D1.5mm
TP5: CLK_BUS; TestPoint_Pad_D1.5mm
TP6: GND; TestPoint_Pad_D1.5mm

Connections:
+3.3V: C6.1, C7.1, DRV1.1 (VM), DRV1.6 (IN1), DRV1.7 (~SLEEP), DRV1.8 (VCC), L2.2, R4.1, R6.1, TP3.1; also elsewhere on the board
+5V: C5.1, C8.1, L1.2, R2.1, R7.1, TP2.1; also elsewhere on the board
CLK: DRV1.2 (OUT1), R8.1, TP4.1; also elsewhere on the board
CLK_BUS: POGO1.1, POGO2.1, POGO3.5, POGO4.5, R9.1, TP5.1
GND: C1.2, C2.2, C5.2, C6.2, C9.2, C10.2, D1.2 (A2), D2.2 (A2), D4.2 (A2), D5.2 (A2), D6.1 (K), D7.1 (K), D8.1 (K), D9.2 (A), DRV1.4 (GND), DRV1.9 (GND), POGO1.2, POGO1.3, POGO2.2, POGO2.3, POGO3.3, POGO3.4, POGO4.3, POGO4.4, R1.2, R3.2, R5.2, REG1.1 (GND), REG2.1 (GND), TP6.1; also elsewhere on the board
unnamed: D3.2 (A), Q1.4 (G), R1.1
unnamed: D6.2 (A), R6.2
unnamed: D7.2 (A), R7.2
unnamed: D8.2 (A), R8.2
unnamed: D9.1 (K), DRV1.5 (IN2), R9.2
unnamed: C3.1, REG1.6 (BOOT)
unnamed: C8.2, R2.2, R3.1, REG1.4 (FB)
unnamed: C3.2, L1.1, REG1.2 (SW)
unnamed: C4.1, REG2.6 (BOOT)
unnamed: C7.2, R4.2, R5.1, REG2.4 (FB)
unnamed: C4.2, L2.1, REG2.2 (SW)
VBUS: D1.1 (A1), D2.1 (A1), D4.1 (A1), D5.1 (A1), POGO1.4, POGO1.5, POGO2.4, POGO2.5, POGO3.1, POGO3.2, POGO4.1, POGO4.2, Q1.5 (D), Q1.6 (D), Q1.7 (D), Q1.8 (D), Q1.9 (D), TP1.1
VBUSP: C1.1, C2.1, C9.1, C10.1, D3.1 (K), Q1.1 (S), Q1.2 (S), Q1.3 (S), REG1.3 (VIN), REG2.3 (VIN)

Notes on the sheet:
LED forward current = 10mA
VBUS = 5V@1.5A - 28V@3.25A
VIN = 5V - 28V VOUT = 5V 3A
IN2 is current limited and over voltage protected
VIN = 5V - 28V VOUT = 3.3V 3A
3.3V Regulator
Reverse polarity
Clock driver
place TVS close to connector
Test Points
Indicator LEDs
Pogo pins TVS + ESD
Pogo pin connectors
Minibadge sockets
R2 Design changes * Replace bucks with TPS54302 * Remove eFuse * Remove LED regulator and PG LEDs * Add Reverse-polarity with PMOS * Protect CLK * Voltage clamp CLK_LOW
5V Regulator

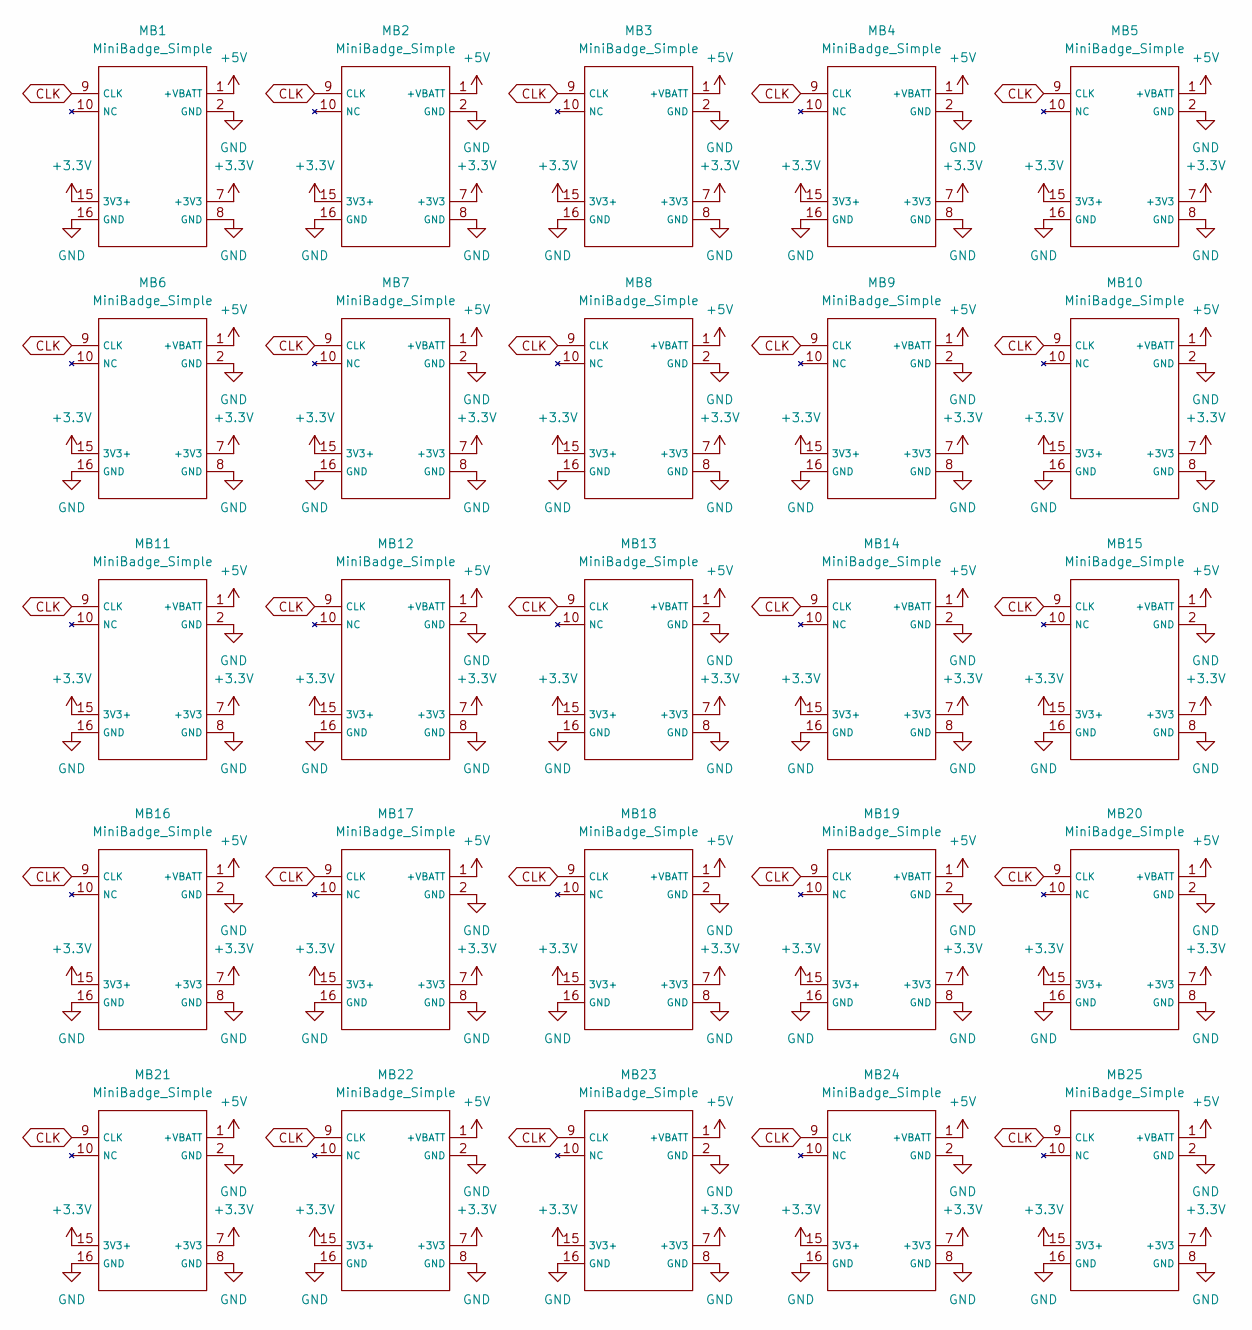
[picture p22: schematic minibadge_sockets.kicad_sch]

Parts:
MB1, MB2, MB3, MB4, MB5, MB6, MB7, MB8, MB9, MB10, MB11, MB12, MB13, MB14, MB15, MB16, MB17, MB18, MB19, MB20, MB21, MB22, MB23, MB24, MB25: MiniBadge_Simple; MiniBadge_Slot_Reflective

Connections:
+3.3V: MB1.7 (+3V3), MB1.15 (3V3+), MB2.7 (+3V3), MB2.15 (3V3+), MB3.7 (+3V3), MB3.15 (3V3+), MB4.7 (+3V3), MB4.15 (3V3+), MB5.7 (+3V3), MB5.15 (3V3+), MB6.7 (+3V3), MB6.15 (3V3+), MB7.7 (+3V3), MB7.15 (3V3+), MB8.7 (+3V3), MB8.15 (3V3+), MB9.7 (+3V3), MB9.15 (3V3+), MB10.7 (+3V3), MB10.15 (3V3+), MB11.7 (+3V3), MB11.15 (3V3+), MB12.7 (+3V3), MB12.15 (3V3+), MB13.7 (+3V3), MB13.15 (3V3+), MB14.7 (+3V3), MB14.15 (3V3+), MB15.7 (+3V3), MB15.15 (3V3+), MB16.7 (+3V3), MB16.15 (3V3+), MB17.7 (+3V3), MB17.15 (3V3+), MB18.7 (+3V3), MB18.15 (3V3+), MB19.7 (+3V3), MB19.15 (3V3+), MB20.7 (+3V3), MB20.15 (3V3+), MB21.7 (+3V3), MB21.15 (3V3+), MB22.7 (+3V3), MB22.15 (3V3+), MB23.7 (+3V3), MB23.15 (3V3+), MB24.7 (+3V3), MB24.15 (3V3+), MB25.7 (+3V3), MB25.15 (3V3+); also elsewhere on the board
+5V: MB1.1 (+VBATT), MB2.1 (+VBATT), MB3.1 (+VBATT), MB4.1 (+VBATT), MB5.1 (+VBATT), MB6.1 (+VBATT), MB7.1 (+VBATT), MB8.1 (+VBATT), MB9.1 (+VBATT), MB10.1 (+VBATT), MB11.1 (+VBATT), MB12.1 (+VBATT), MB13.1 (+VBATT), MB14.1 (+VBATT), MB15.1 (+VBATT), MB16.1 (+VBATT), MB17.1 (+VBATT), MB18.1 (+VBATT), MB19.1 (+VBATT), MB20.1 (+VBATT), MB21.1 (+VBATT), MB22.1 (+VBATT), MB23.1 (+VBATT), MB24.1 (+VBATT), MB25.1 (+VBATT); also elsewhere on the board
CLK: MB1.9 (CLK), MB2.9 (CLK), MB3.9 (CLK), MB4.9 (CLK), MB5.9 (CLK), MB6.9 (CLK), MB7.9 (CLK), MB8.9 (CLK), MB9.9 (CLK), MB10.9 (CLK), MB11.9 (CLK), MB12.9 (CLK), MB13.9 (CLK), MB14.9 (CLK), MB15.9 (CLK), MB16.9 (CLK), MB17.9 (CLK), MB18.9 (CLK), MB19.9 (CLK), MB20.9 (CLK), MB21.9 (CLK), MB22.9 (CLK), MB23.9 (CLK), MB24.9 (CLK), MB25.9 (CLK); also elsewhere on the board
GND: MB1.2 (GND), MB1.8 (GND), MB1.16 (GND), MB2.2 (GND), MB2.8 (GND), MB2.16 (GND), MB3.2 (GND), MB3.8 (GND), MB3.16 (GND), MB4.2 (GND), MB4.8 (GND), MB4.16 (GND), MB5.2 (GND), MB5.8 (GND), MB5.16 (GND), MB6.2 (GND), MB6.8 (GND), MB6.16 (GND), MB7.2 (GND), MB7.8 (GND), MB7.16 (GND), MB8.2 (GND), MB8.8 (GND), MB8.16 (GND), MB9.2 (GND), MB9.8 (GND), MB9.16 (GND), MB10.2 (GND), MB10.8 (GND), MB10.16 (GND), MB11.2 (GND), MB11.8 (GND), MB11.16 (GND), MB12.2 (GND), MB12.8 (GND), MB12.16 (GND), MB13.2 (GND), MB13.8 (GND), MB13.16 (GND), MB14.2 (GND), MB14.8 (GND), MB14.16 (GND), MB15.2 (GND), MB15.8 (GND), MB15.16 (GND), MB16.2 (GND), MB16.8 (GND), MB16.16 (GND), MB17.2 (GND), MB17.8 (GND), MB17.16 (GND), MB18.2 (GND), MB18.8 (GND), MB18.16 (GND), MB19.2 (GND), MB19.8 (GND), MB19.16 (GND), MB20.2 (GND), MB20.8 (GND), MB20.16 (GND), MB21.2 (GND), MB21.8 (GND), MB21.16 (GND), MB22.2 (GND), MB22.8 (GND), MB22.16 (GND), MB23.2 (GND), MB23.8 (GND), MB23.16 (GND), MB24.2 (GND), MB24.8 (GND), MB24.16 (GND), MB25.2 (GND), MB25.8 (GND), MB25.16 (GND); also elsewhere on the board
