Beehive-Engineering/Minibadge-Displays/5x5 Display/5x5 Display.kicad_pcb

## KiCad design 5x5 Display/5x5 Display.kicad_pcb (continued)

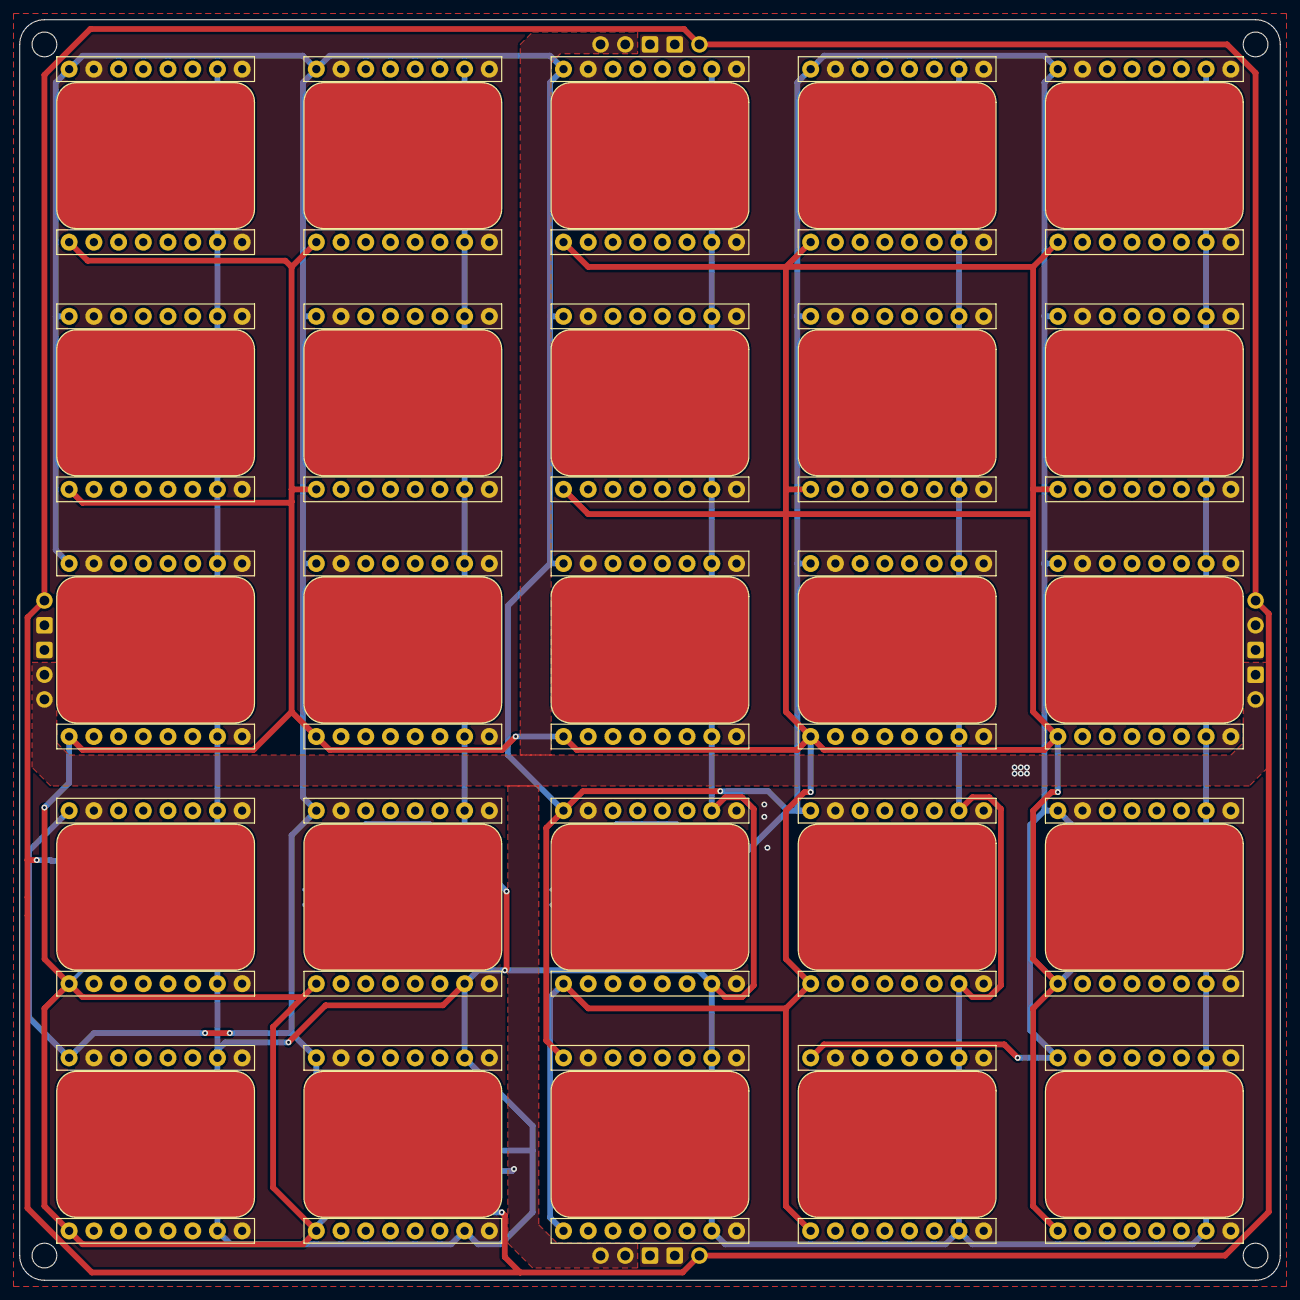
[picture p23: board 5x5 Display.kicad_pcb from above]

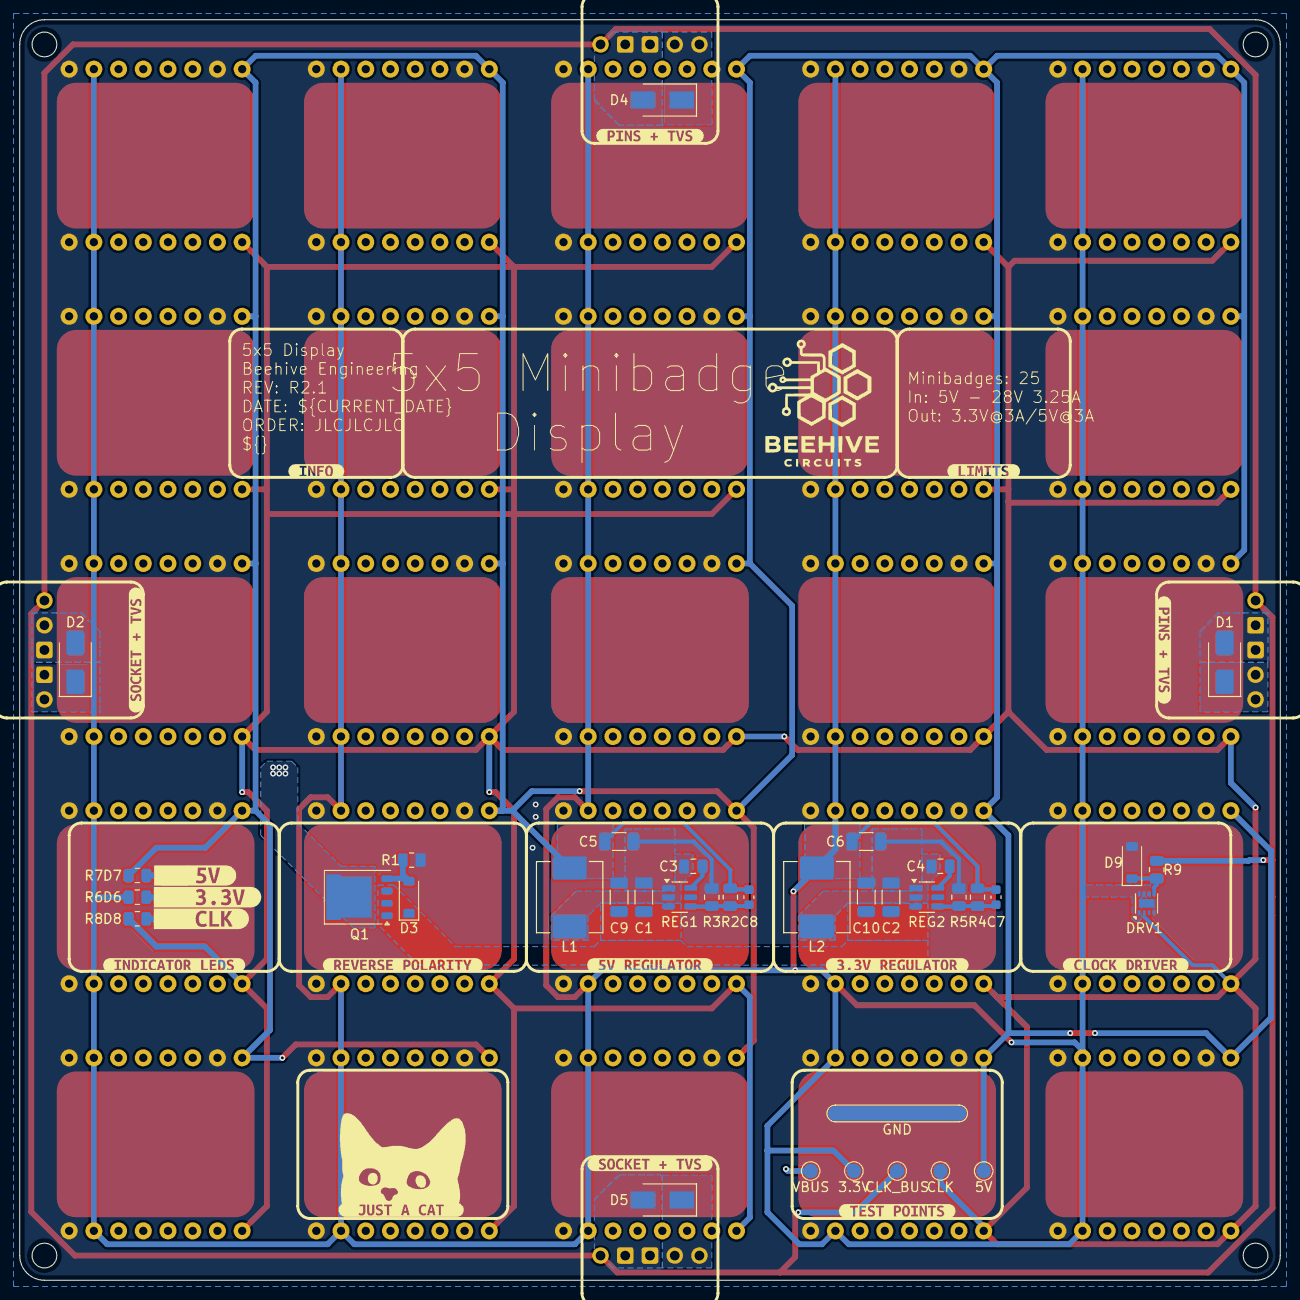
[picture p24: board 5x5 Display.kicad_pcb from below]

Board: 2 copper layers, 129.5 x 129.5 mm, 86 parts (57 on the bottom side), 18 nets.

Other parts of the board:
kibuzzard-696F0B33: G***; kibuzzard-696F0B33
kibuzzard-696F07FC: G***; kibuzzard-696F07FC
kibuzzard-696F09B6: G***; kibuzzard-696F09B6
kibuzzard-696F080D: G***; kibuzzard-696F080D
kibuzzard-696F081C: G***; kibuzzard-696F081C
kibuzzard-696F082C: G***; kibuzzard-696F082C
kibuzzard-696F097A: G***; kibuzzard-696F097A
kibuzzard-696F0995: G***; kibuzzard-696F0995
kibuzzard-696F1606: G***; kibuzzard-696F1606
kibuzzard-69658F74: G***; kibuzzard-69658F74
kibuzzard-69658FBF: G***; kibuzzard-69658FBF
kibuzzard-69658FCE: G***; kibuzzard-69658FCE
kibuzzard-69658FDE: G***; kibuzzard-69658FDE
kibuzzard-6965973E: G***; kibuzzard-6965973E
kibuzzard-69659724: G***; kibuzzard-69659724
kibuzzard-69659941: G***; kibuzzard-69659941
logo1: Beehive Logo; LOGO
