Beehive-Engineering/Minibadge-Displays/(commit log)

2026-11-10 4x7 Display: R1 schematic, BOM values, test layout
    Claude-Session: https://claude.ai/code/session_01GWJ4F4vxoXYRmjdzZjyghF
    [4x7 Display.kicad_pcb, 4x7 Display.kicad_sch, test layout.kicad_pcb]
2026-11-10 localized layout done
    [4x7 Display.kicad_pcb, 4x7 Display.kicad_sch]
2026-11-11 R1 routing 99.9% done
    [4x7 Display.kicad_pcb, 4x7 Display.kicad_sch]
2026-11-12 R1 wrapup
    [4x7 Display.kicad_pcb, 4x7 Display.kicad_sch]
2026-11-13 extra touches
    [4x7 Display-User_Comments.dxf, 4x7 Display.kicad_pcb]
